biopmr/ModExo/README.md

ModExo (https://github.com/biopmr/ModExo)

## Contents
- [Landing Page](https://github.com/biopmr/ModExo)
- [Main Code](https://github.com/biopmr/ModExo/blob/master/arduino_control/arduino_control.ino)
- [Hardware](https://github.com/biopmr/ModExo/blob/master/hardware)
- [Experimental](https://github.com/biopmr/ModExo/blob/master/experimental)
- [Documents](https://github.com/biopmr/ModExo/blob/master/documents)
- Discussion

## Intro
Exoskeletons are often called wearable robots because of it's close interaction with the human. Being so, the exoskeletons must be responsive to user movement.

In this project, we desire to investigate the human joint and robotic joint interaction in a modular approach in a way that this is usefull for several applications.

## How to contribute
This project is on it's initial stages. If you want to contribute, take a look at the [Issues](https://github.com/biopmr/ModExo/issues) for already identified needs or at the [main code](https://github.com/biopmr/ModExo/blob/master/arduino_control/arduino_control.ino) and identify issues yourself!

## Testing
The hardware is not easy to set up by yourself. A workflow to test remote contributions is still needed. For now, just contact the e-mail below and we'll upload the changes and publish the results.

https://www.youtube.com/watch?v=oU2QiyaPxdo  
https://www.youtube.com/watch?v=PE7NVD3MYoc

## Contact
rafaelsanchezsouza@gmail.com

## License
[MIT](https://github.com/biopmr/modexo/blob/master/LICENSE)

Developed at Laboratório de Biomecatrônica at the Universidade de São Paulo.
