biopmr/ModExo/hardware/portableCase/README.md

  The ModExo Portable Case was built by Priscila Komatsu ([primiki](https://github.com/primiki)), a Lab's collaborator, and designed by Priscila Komatsu and Rafael Sanchez Souza ([rafaelsanchezsouza](https://github.com/rafaelsanchezsouza)). The result can be seen in figures that follows. 

## Requirements
The following requirements were defined for the case design:
- All the mechanical interface and control hardware must fit a portable case
- The robotic joint movement axis will rotate in parallel with the gravity
- The height of the case must be as low as possible 
- An emergency button should shut the whole system down if needed
- There should be communication between the control hardware inside the case and the equipment outside the case
- There should be space for control hardware volume, in the case that another degree of freedom is added 
- The control hardware must be visible with the case closed
- The interior of the case must be of easy access, in the need of maintenance
- There must be an exit for the power supply air expelled by the fan
- The motor must be supported by a rigid structure, that can support the weight of a person's arm

To follow these requirements, a case has been developed with a rectangular shape and the upper half is transparent and removable
with a slide motion. One side has a swivel joint to be easily accessible from the outside.

The material chosen to construct this case was a wood, because it is easy to manufacture and has a low cost, because the transparent part was chosen a
acrylic plate.

For the design developed, it used 3D CAD software, the Inventor by Autodesk.

## Pictures

ModExo Case

ModExo Case

ModExo Case

ModExo Case
