biopmr/ModExo/_images/_logo/readme.md

Gear by i cons from the Noun Project
Bone Joints by Vectors Market from the Noun Project
