biopmr/ModExo/documents/README.md

Here are gathered the most important documents used in the project, including datasheets, manuals, catalogues, amongst others. The following standard is applied for naming and finding documents:

	DocumentType-RelatedSubsystem-Content

For example, the manual which describes the cabling standards for the EPOS2 is:

	Manual-EPOS2-CableReferenceGuide.pdf

This standard is based on the document named Tutorial-Documentation-FileNamingConvention.pdf
