biopmr/ModExo/_images/_adaptive_control/a_3_3_3_ahat_3_01_3_tau_3.png

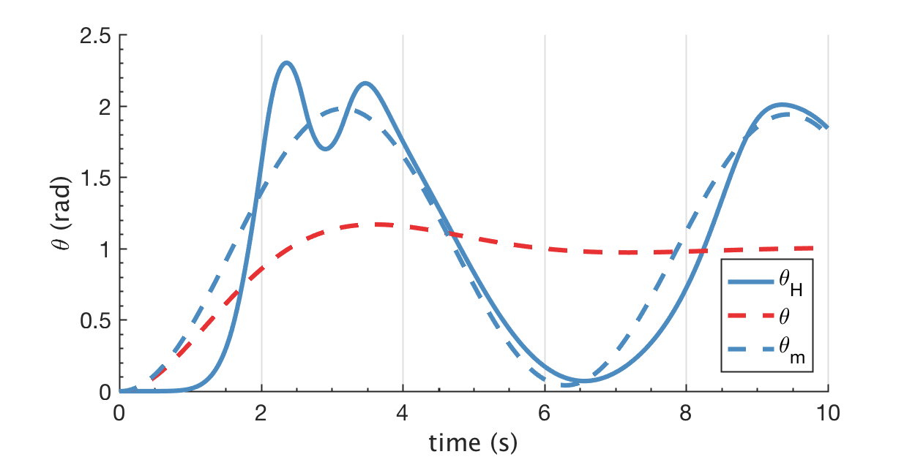
_images/_adaptive_control/a_3_3_3_ahat_3_01_3_tau_3.png
