biopmr/ModExo/_images/_adaptive_control/a_3_3_3_av_3_3_0_tau_3.png

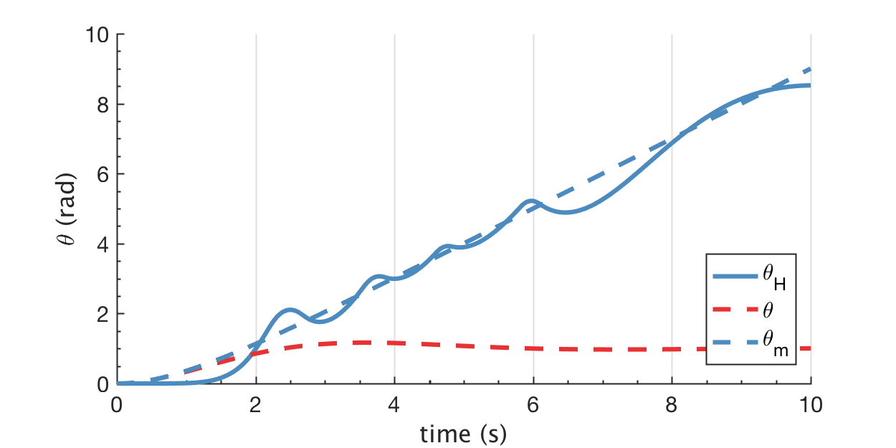
_images/_adaptive_control/a_3_3_3_av_3_3_0_tau_3.png
