biopmr/ModExo/_images/_adaptive_control/two_models_com_controle.png

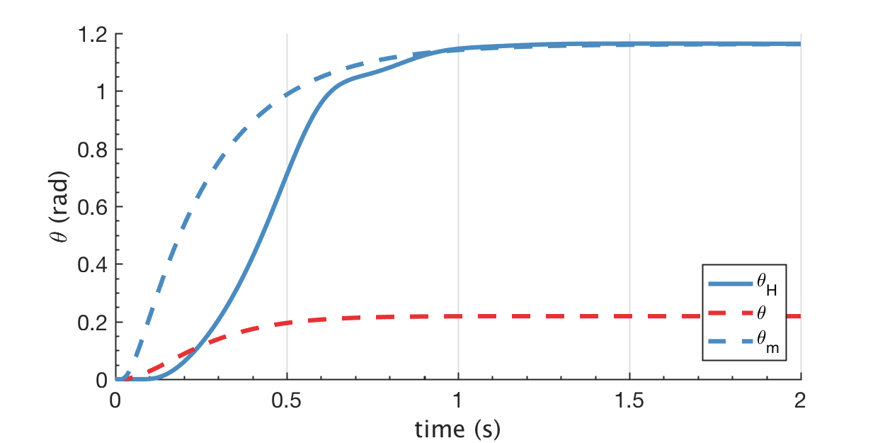
_images/_adaptive_control/two_models_com_controle.png
