biopmr/ModExo/telemetryviewer.png

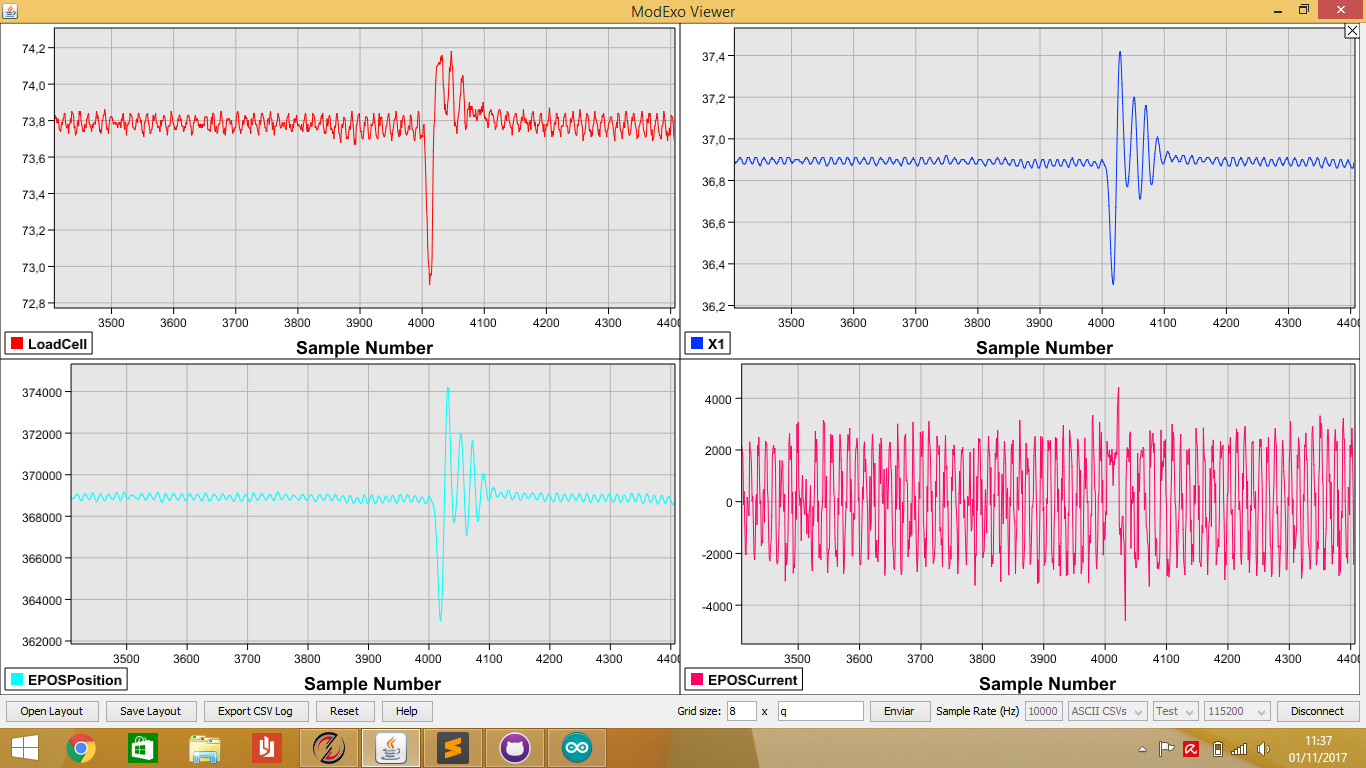
telemetryviewer.png
