biopmr/ModExo/hardware/wireCase/proteção celula de carga Rafa.stp

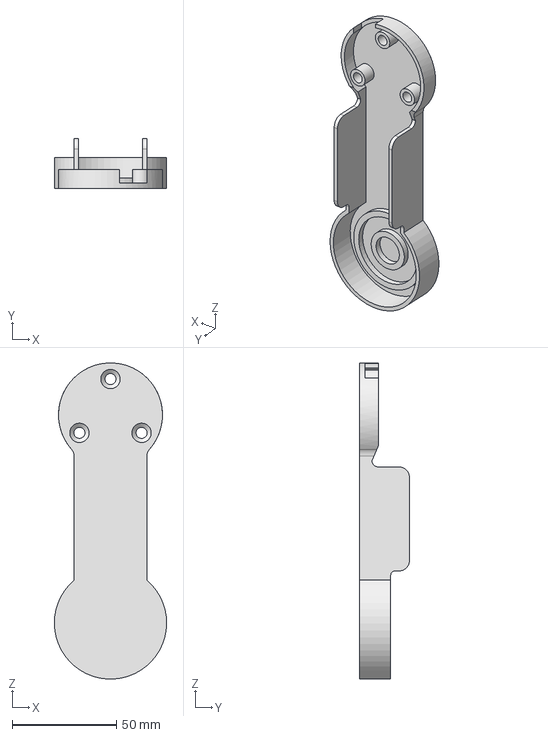
[picture p5: CAD file, 2017-11-28]
hardware/wireCase/proteção celula de carga Rafa.stp
54.0 x 24.0 x 151.9 mm
