biopmr/ModExo/(list of files, cad)

Other CAD files:
hardware/wireCase/proteção celula de carga Rafa.igs
hardware/wireCase/proteção celula de carga Rafa.ipt
