biopmr/ModExo/experimental/20170712-loadcell_tests-setup.png

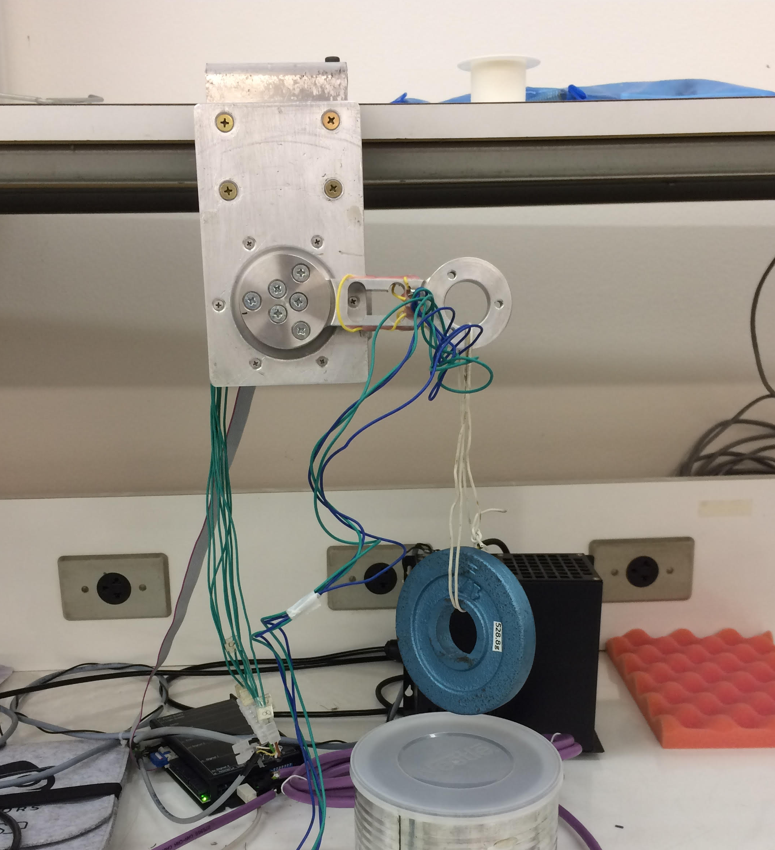
experimental/20170712-loadcell_tests-setup.png
