biopmr/ModExo/matlab/arduino_tests/decreasingStep.png

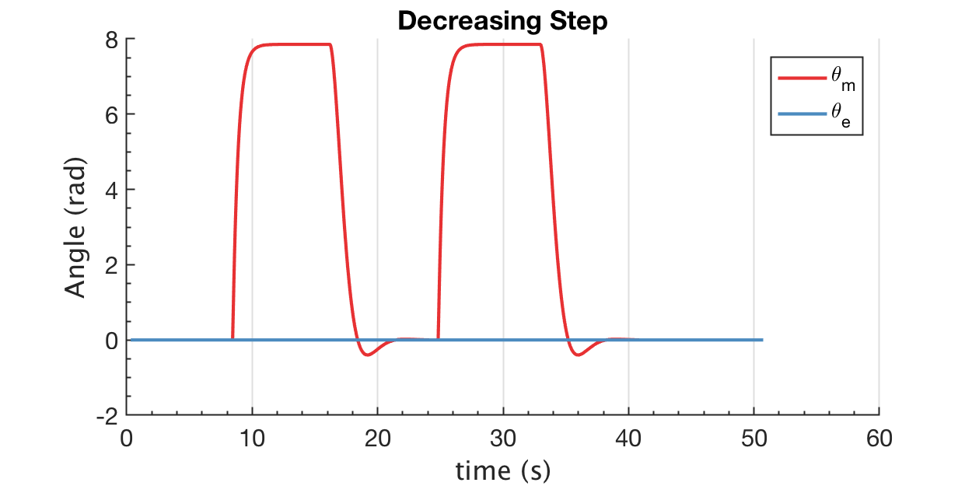
matlab/arduino_tests/decreasingStep.png
