biopmr/ModExo/experimental/csvData/20170705-interruptedFall-i_20_b_20_k_100.csv

Sample Number (10000 samples per second) | LoadCell () | X1 () | X2 () | X3 () | EPOSPosition () | EPOSCurrent ()
0 | 643.35 | 0.0 | 0.0 | 12866.92 | 4.0 | 19.0
1 | 643.39 | 0.0 | 64.33 | 6434.42 | 4.0 | 65526.0
2 | 642.85 | 0.32 | 96.51 | 1919.61 | 4.0 | 2.0
3 | 642.38 | 0.8 | 106.1 | -979.64 | 4.0 | 65526.0
4 | 643.27 | 1.33 | 101.21 | -2594.26 | 4.0 | 2.0
5 | 643.47 | 1.84 | 88.24 | -3317.25 | 4.0 | 65521.0
6 | 643.76 | 2.28 | 71.65 | -3417.56 | 4.0 | 41.0
7 | 642.95 | 2.64 | 54.56 | -3157.8 | 5.0 | 65101.0
8 | 642.79 | 2.91 | 38.77 | -2673.33 | 4.0 | 54.0
9 | 643.03 | 3.11 | 25.41 | -2107.46 | 4.0 | 65500.0
10 | 643.07 | 3.23 | 14.87 | -1561.04 | 4.0 | 65414.0
11 | 643.23 | 3.31 | 7.06 | -1074.52 | 4.0 | 6.0
12 | 643.44 | 3.34 | 1.69 | -674.35 | 4.0 | 65419.0
13 | 642.8 | 3.35 | -1.68 | -383.82 | 4.0 | 65375.0
14 | 642.66 | 3.34 | -3.6 | -161.17 | 4.0 | 65380.0
15 | 643.55 | 3.33 | -4.41 | 9.39 | 4.0 | 65393.0
16 | 642.81 | 3.3 | -4.36 | 77.9 | 4.0 | 65414.0
17 | 643.15 | 3.28 | -3.97 | 132.87 | 4.0 | 65410.0
18 | 642.98 | 3.26 | -3.31 | 142.46 | 4.0 | 65397.0
19 | 643.35 | 3.25 | -2.59 | 144.72 | 4.0 | 65375.0
20 | 643.06 | 3.23 | -1.87 | 118.45 | 4.0 | 65426.0
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
