biopmr/ModExo/experimental/csvData/20170707-delayTests_1.csv

Sample Number (10000 samples per second) | LoadCell () | X1 () | X2 () | X3 () | EPOSPosition () | EPOSCurrent () | Encoder () | Time (ms)
0 | 100.27 | 0.4 | -1.85 | 721.57 | 3870.0 | 31440.0 | 3802.0 | 332.0
1 | 100.98 | 0.4 | -1.78 | 715.4 | 3869.0 | 23450.0 | 0.0 | 382.0
2 | 94.66 | 0.39 | 1.79 | -728.32 | 3960.0 | 630040.0 | 0.0 | 433.0
3 | 100.27 | 0.4 | -1.85 | 721.57 | 3870.0 | 31440.0 | 0.0 | 484.0
4 | 95.25 | 0.0 | 0.0 | 2381.27 | 0.0 | 0.0 | 0.0 | 534.0
5 | 91.58 | 0.0 | 11.91 | -2175.26 | 65.0 | 14120.0 | 0.0 | 584.0
6 | 87.63 | 0.06 | 1.03 | 1432.41 | 4.2949673E9 | 647250.0 | 0.0 | 634.0
7 | 81.48 | 0.06 | 8.19 | -1439.37 | 108.0 | 32310.0 | 0.0 | 686.0
8 | 89.62 | 0.11 | 1.0 | 1207.0 | 573.0 | 627320.0 | 0.0 | 736.0
9 | 83.31 | 0.11 | 7.03 | -1244.86 | 933.0 | 636580.0 | 0.0 | 786.0
10 | 90.9 | 0.15 | 0.81 | 1059.28 | 1131.0 | 635340.0 | 0.0 | 836.0
11 | 86.93 | 0.15 | 6.1 | -1051.33 | 1224.0 | 46220.0 | 0.0 | 886.0
12 | 91.96 | 0.18 | 0.85 | 854.96 | 1523.0 | 628190.0 | 0.0 | 937.0
13 | 88.08 | 0.18 | 5.12 | -871.58 | 1653.0 | 27820.0 | 0.0 | 988.0
14 | 92.76 | 0.38 | 1.5 | -610.68 | 38.98 | 829.62 | 0.0 | 1038.0
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
