biopmr/ModExo/experimental/csvData/20170707-delayTests_2.csv

Sample Number (10000 samples per second) | LoadCell () | X1 () | X2 () | X3 () | EPOSPosition () | EPOSCurrent () | Encoder () | Time (ms)
1 | 41.41 | 0.0 | 0.0 | 1035.18 | 43699.0 | 0.0 | 0.0 | 320.0
2 | 53.45 | 0.0 | 5.18 | -604.76 | 42642.0 | 59743.0 | 0.0 | 349.0
3 | 59.3 | 0.03 | 2.15 | 513.82 | 40072.0 | 60990.0 | 0.0 | 399.0
4 | 67.02 | 0.04 | 4.72 | -323.91 | 37092.0 | 59309.0 | 0.0 | 449.0
5 | 72.68 | 0.06 | 3.1 | 277.27 | 33762.0 | 62342.0 | 0.0 | 500.0
6 | 80.4 | 0.08 | 4.49 | -146.41 | 30426.0 | 62419.0 | 0.0 | 550.0
7 | 89.1 | 0.1 | 3.76 | 205.26 | 27091.0 | 61892.0 | 0.0 | 601.0
8 | 86.41 | 0.12 | 4.78 | -364.16 | 23763.0 | 62466.0 | 0.0 | 651.0
9 | 92.32 | 0.14 | 2.96 | 317.0 | 20427.0 | 62316.0 | 0.0 | 702.0
10 | 97.16 | 0.16 | 4.55 | -248.99 | 17094.0 | 62233.0 | 0.0 | 752.0
11 | 102.35 | 0.18 | 3.3 | 205.54 | 13769.0 | 7.0 | 0.0 | 802.0
12 | 104.88 | 0.19 | 4.33 | -219.85 | 10780.0 | 65511.0 | 0.0 | 852.0
13 | 108.94 | 0.22 | 3.23 | 158.56 | 8216.0 | 65439.0 | 0.0 | 903.0
14 | 112.54 | 0.23 | 4.02 | -149.63 | 6077.0 | 283.0 | 0.0 | 954.0
15 | 113.6 | 0.25 | 3.27 | 31.69 | 4054.0 | 419.0 | 0.0 | 1004.0
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
