biopmr/ModExo/experimental/20170707-delay_test_1-response.png

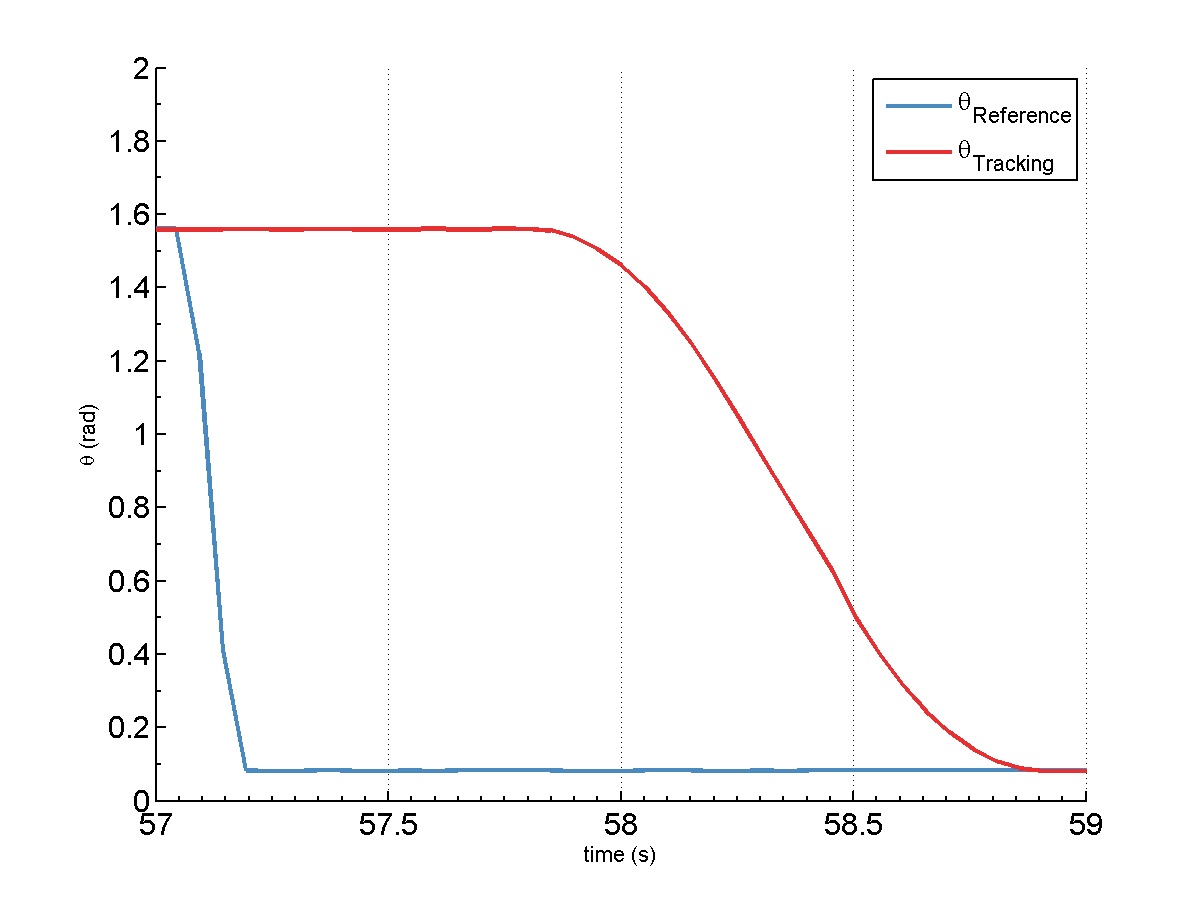
experimental/20170707-delay_test_1-response.png
