biopmr/ModExo/experimental/20170707-delay_test_2-response.png

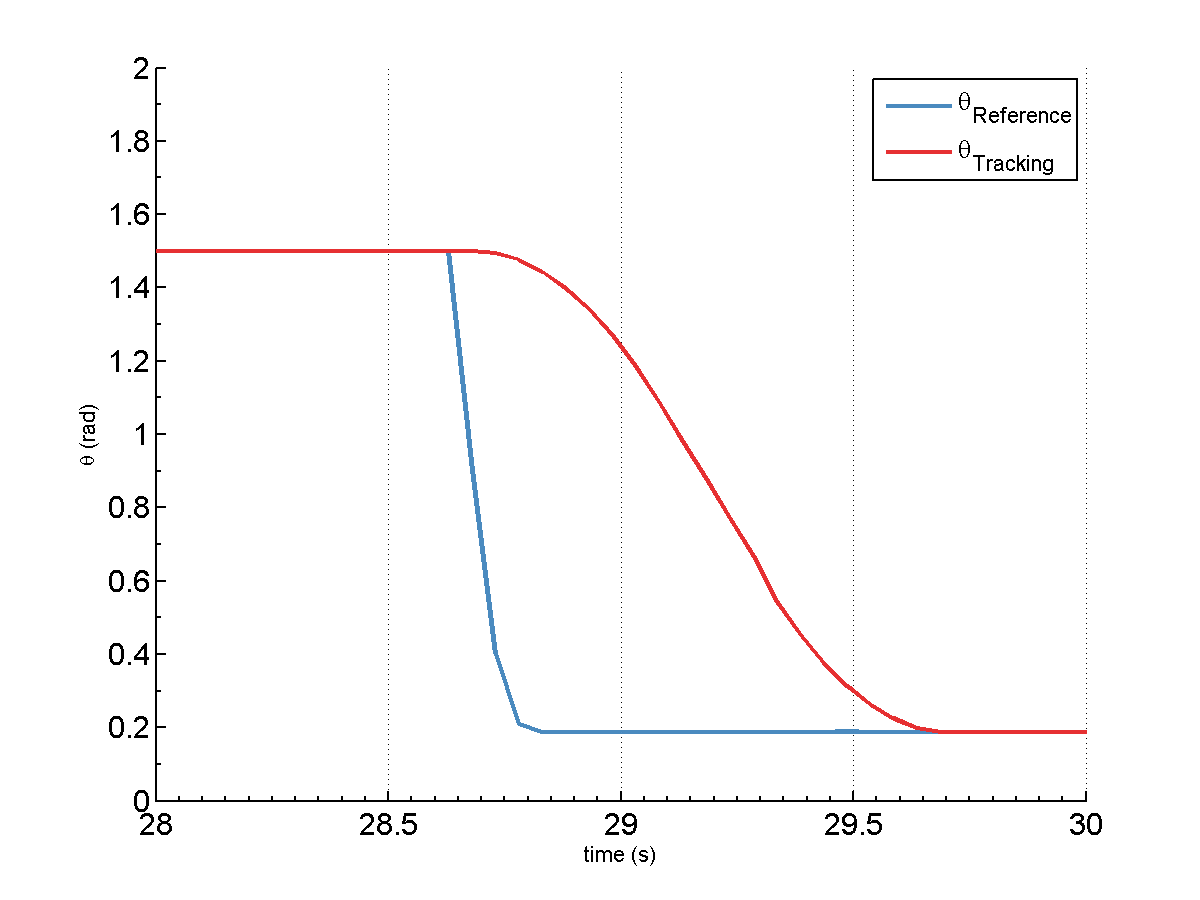
experimental/20170707-delay_test_2-response.png
