biopmr/ModExo/experimental/20170707-delay_test_3-response.png

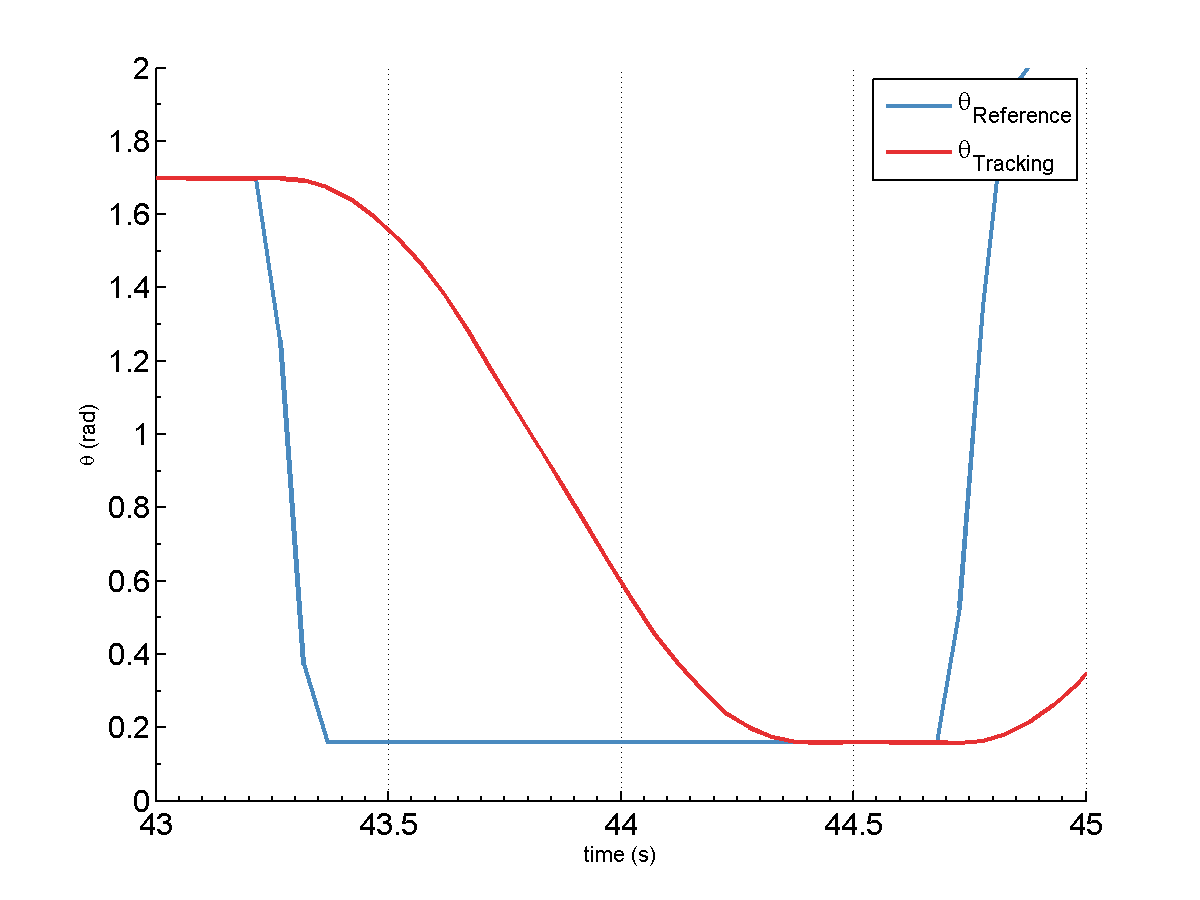
experimental/20170707-delay_test_3-response.png
