biopmr/ModExo/experimental/20170707-delay_tests_1-settings.png

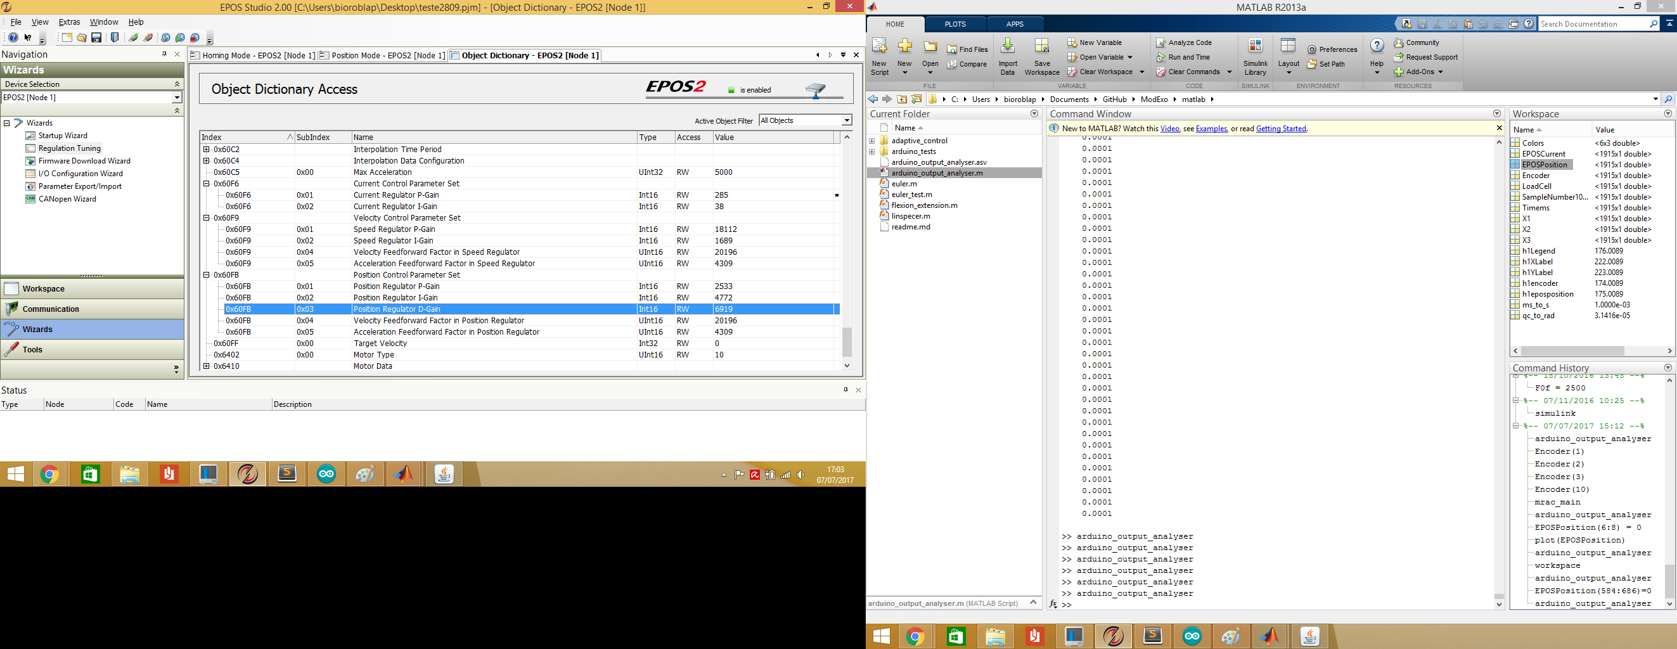
experimental/20170707-delay_tests_1-settings.png
