biopmr/ModExo/experimental/20170707-delay_tests_3-settings.png

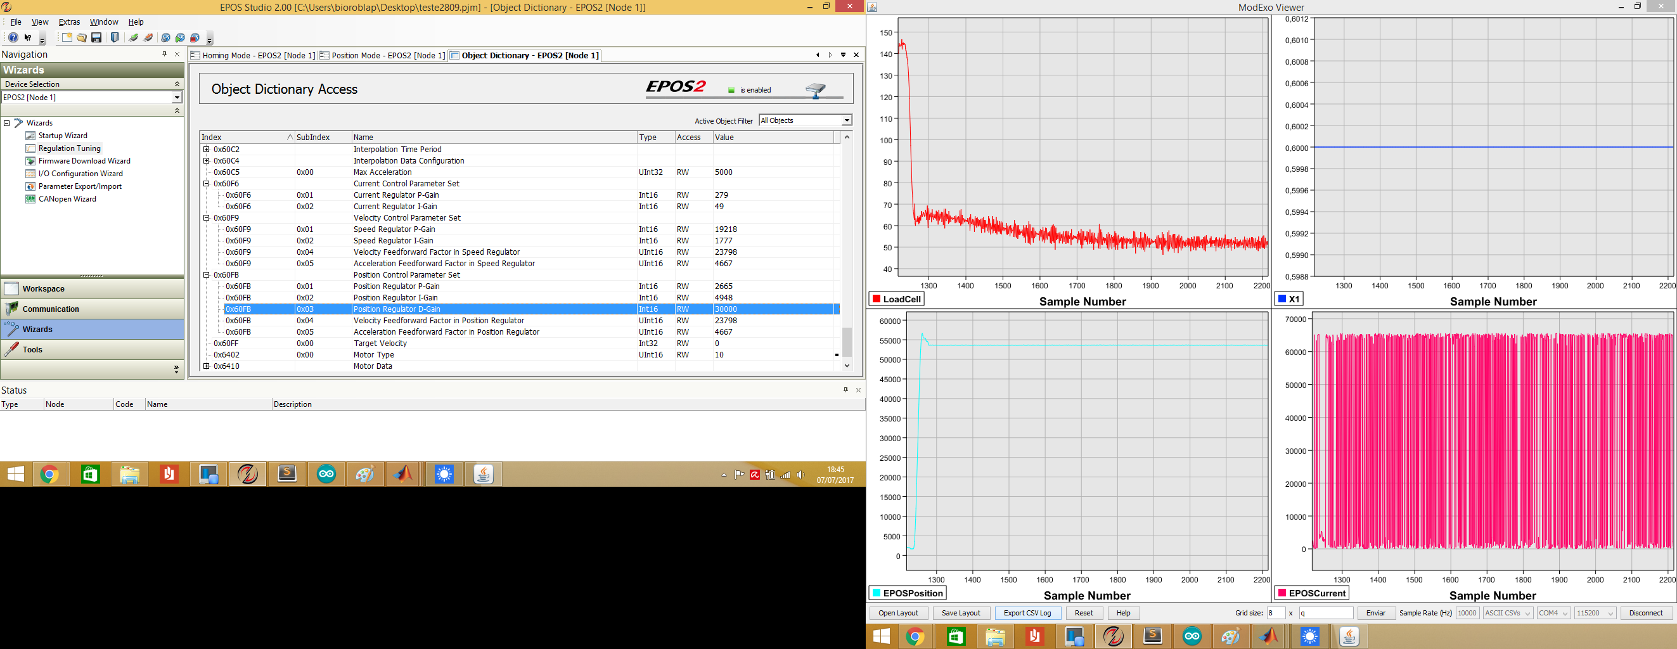
experimental/20170707-delay_tests_3-settings.png
