biopmr/ModExo/experimental/20170712-loadcell_tests.png

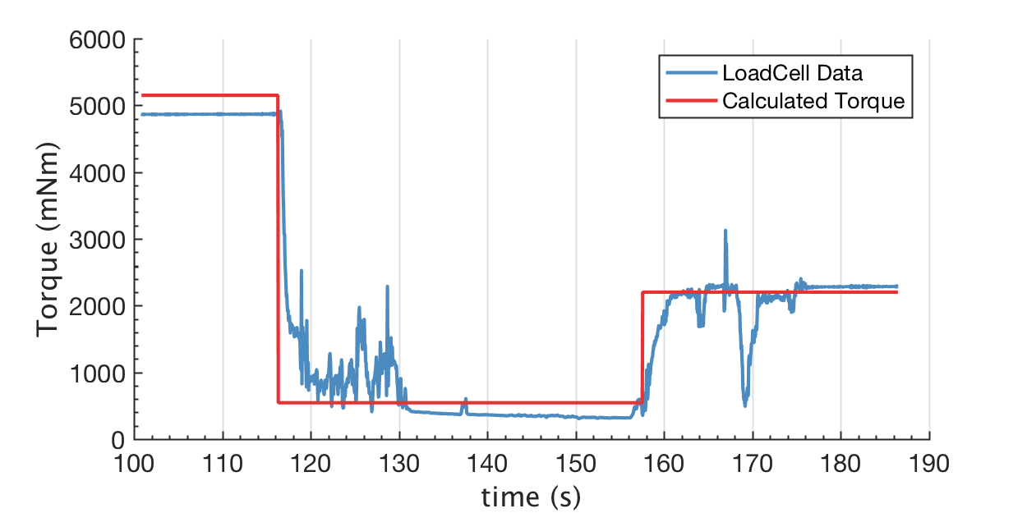
experimental/20170712-loadcell_tests.png
