biopmr/ModExo/experimental/20170712-loadcell_tests_2.png

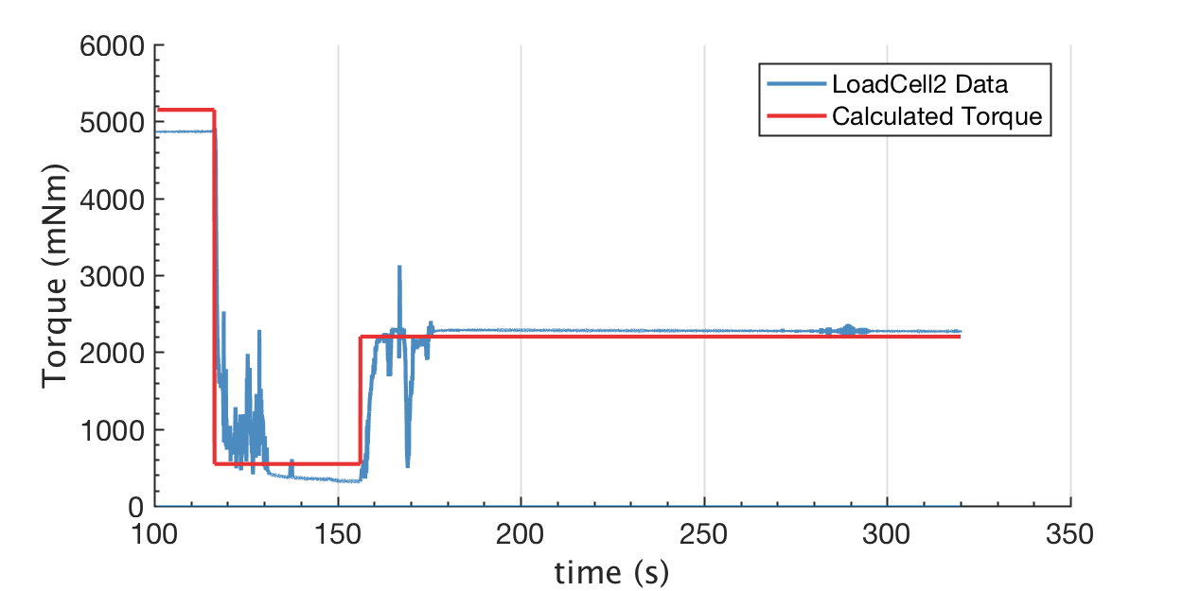
experimental/20170712-loadcell_tests_2.png
