biopmr/ModExo/matlab/adaptive_control/test_mrac.png

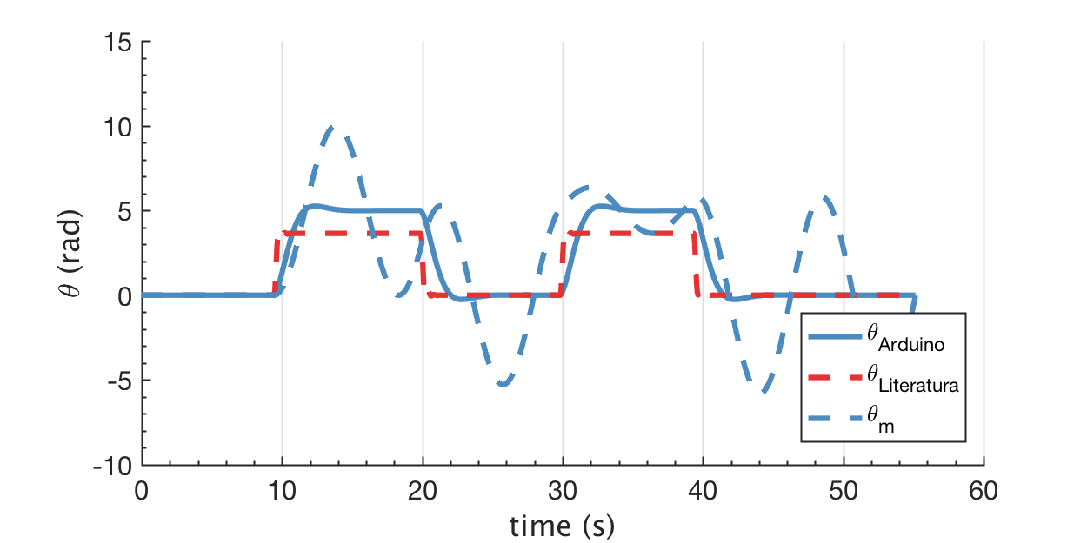
matlab/adaptive_control/test_mrac.png
