biopmr/ModExo/matlab/arduino_tests/delay_test_1_response.png

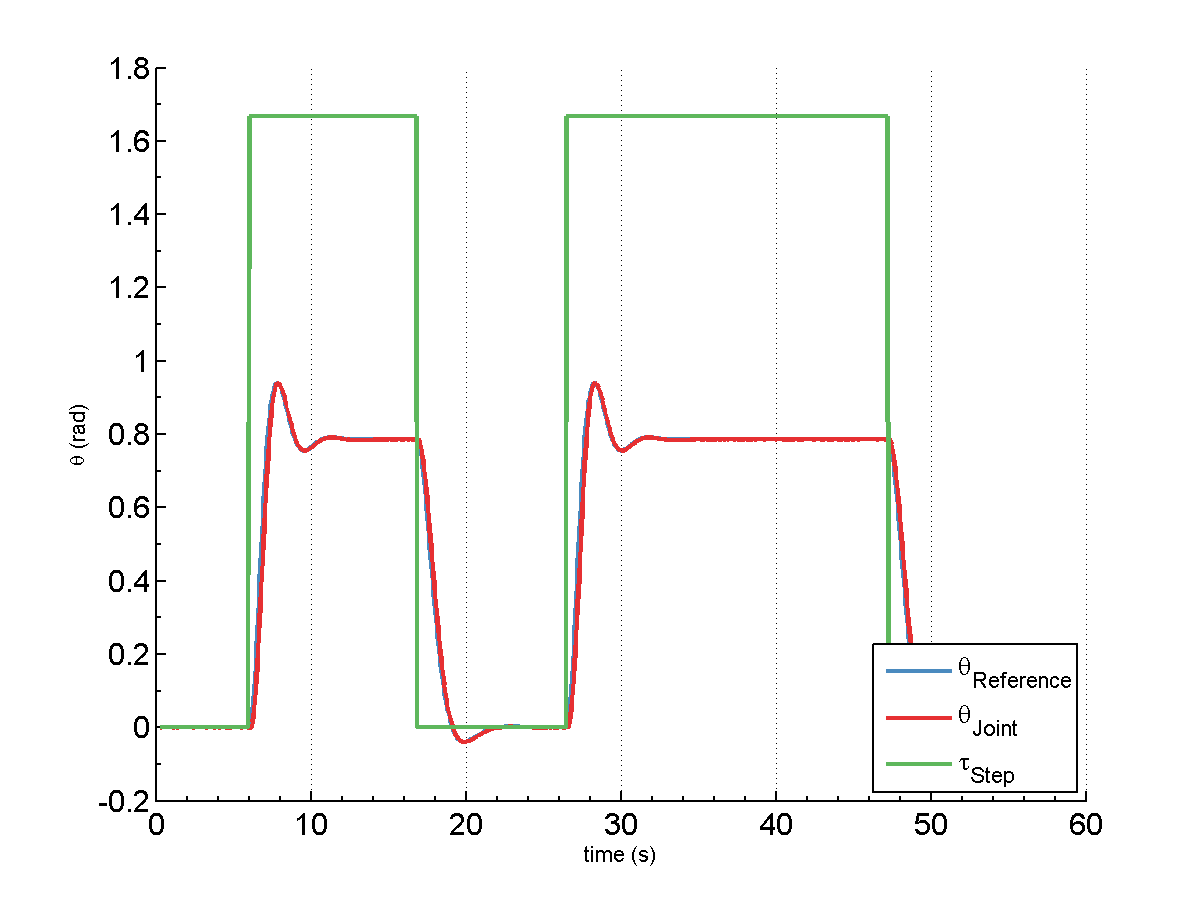
matlab/arduino_tests/delay_test_1_response.png
