biopmr/ModExo/matlab/arduino_tests/delay_test_2_response.png

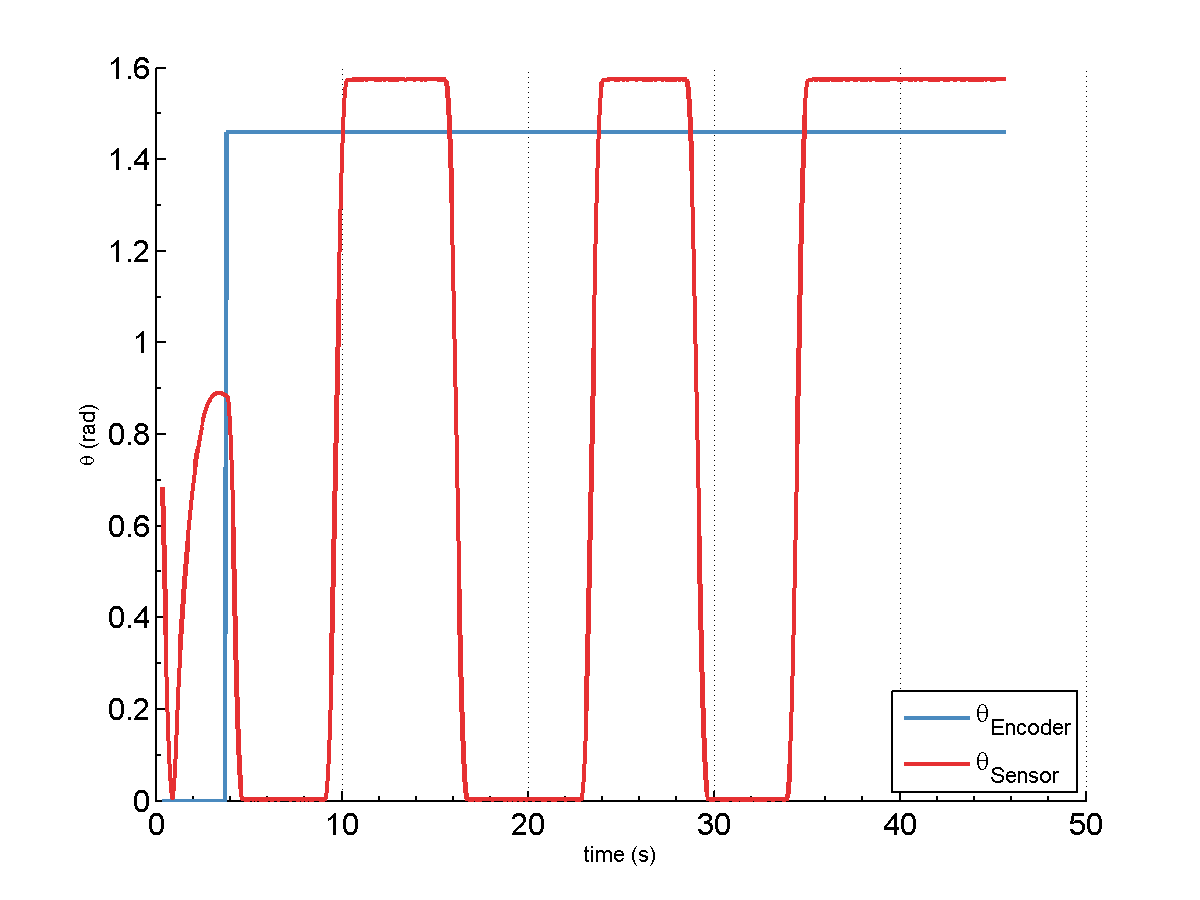
matlab/arduino_tests/delay_test_2_response.png
