biopmr/ModExo/matlab/arduino_tests/impedance_1_plot_1.png

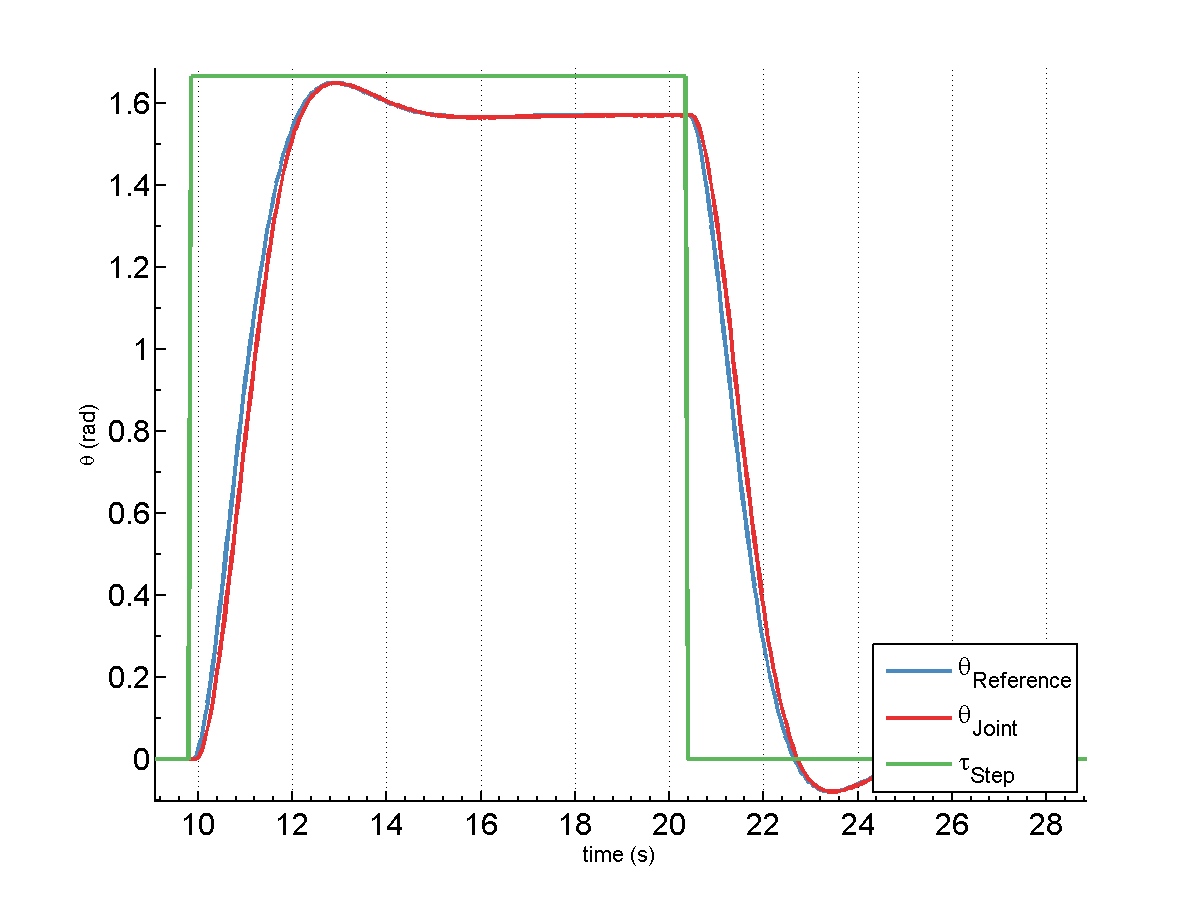
matlab/arduino_tests/impedance_1_plot_1.png
