biopmr/ModExo/matlab/arduino_tests/impedance_1_plot_2.png

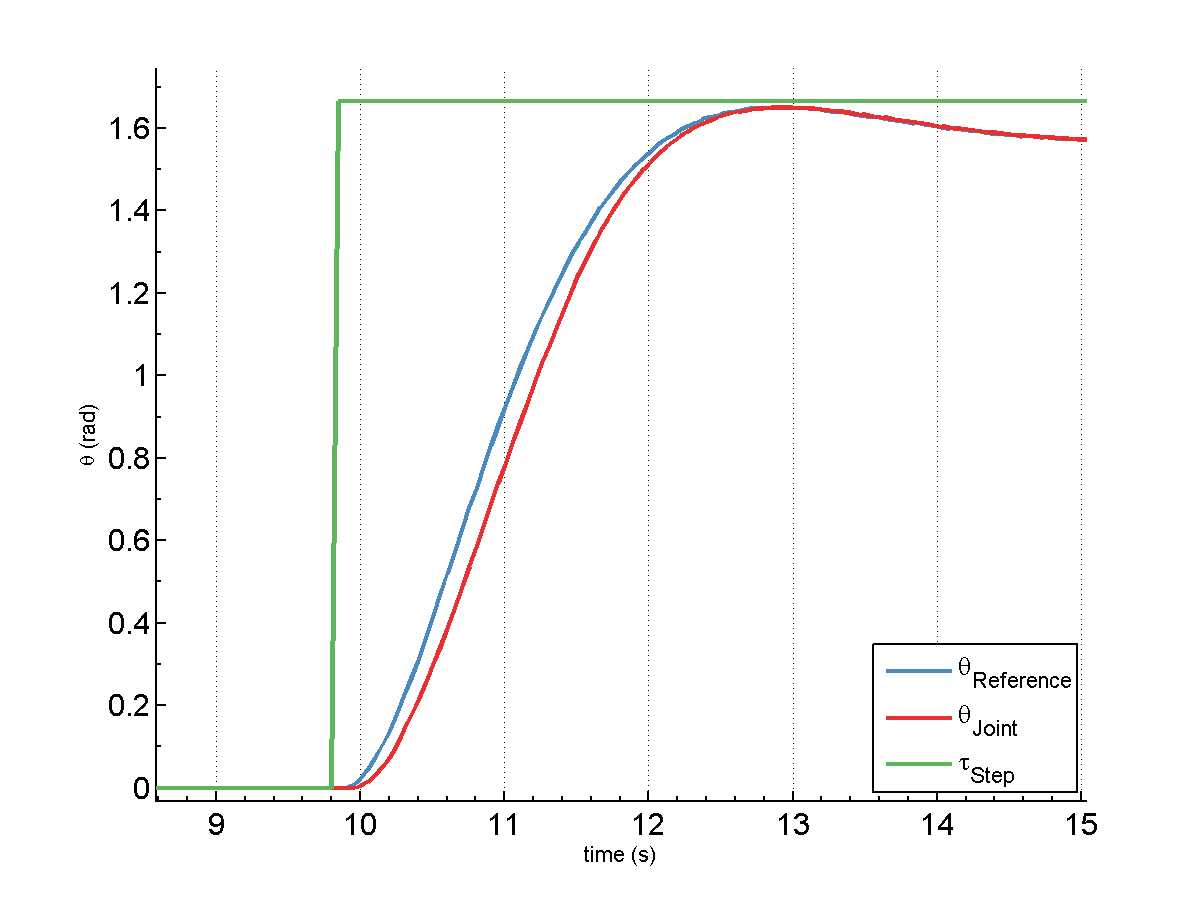
matlab/arduino_tests/impedance_1_plot_2.png
