biopmr/ModExo/matlab/arduino_tests/impedance_2_plot_1.png

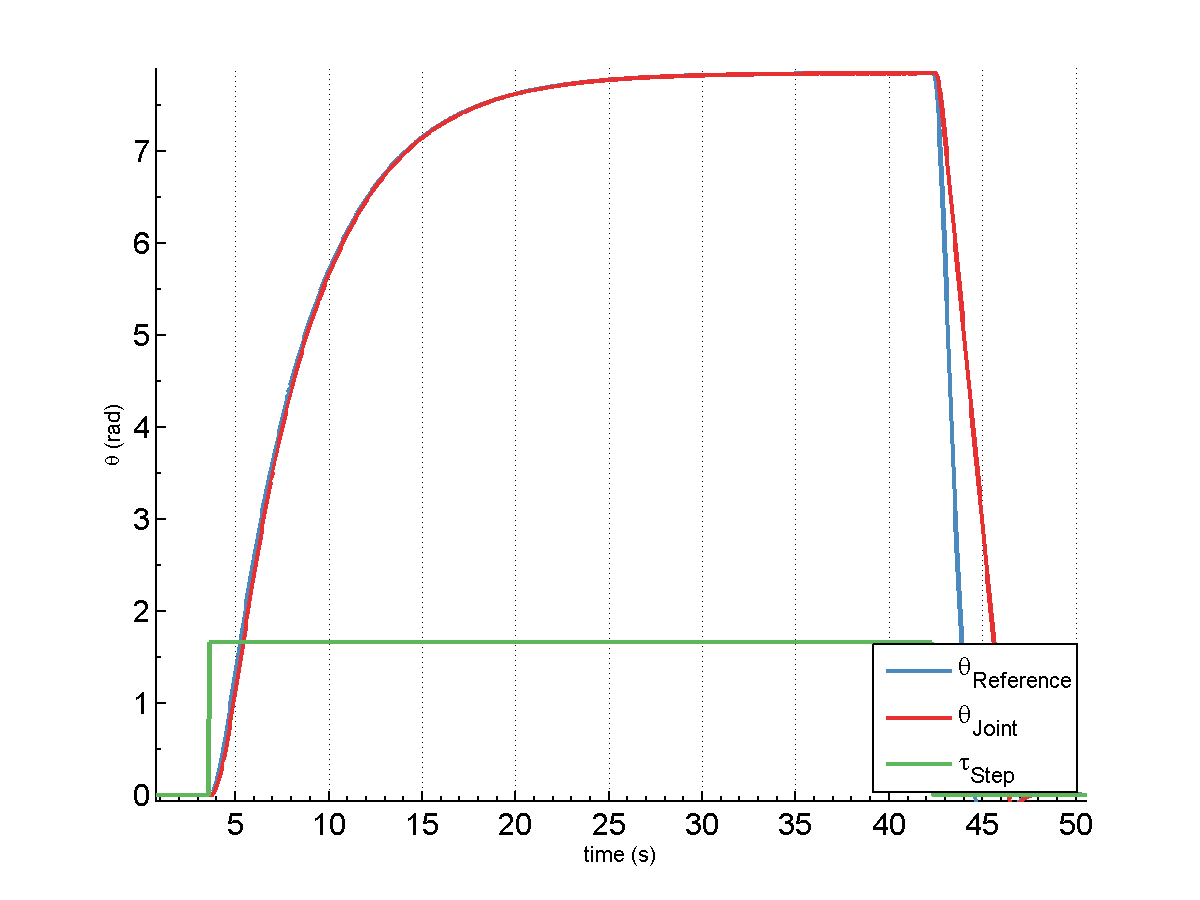
matlab/arduino_tests/impedance_2_plot_1.png
