biopmr/ModExo/matlab/arduino_tests/impedance_3_plot_1.png

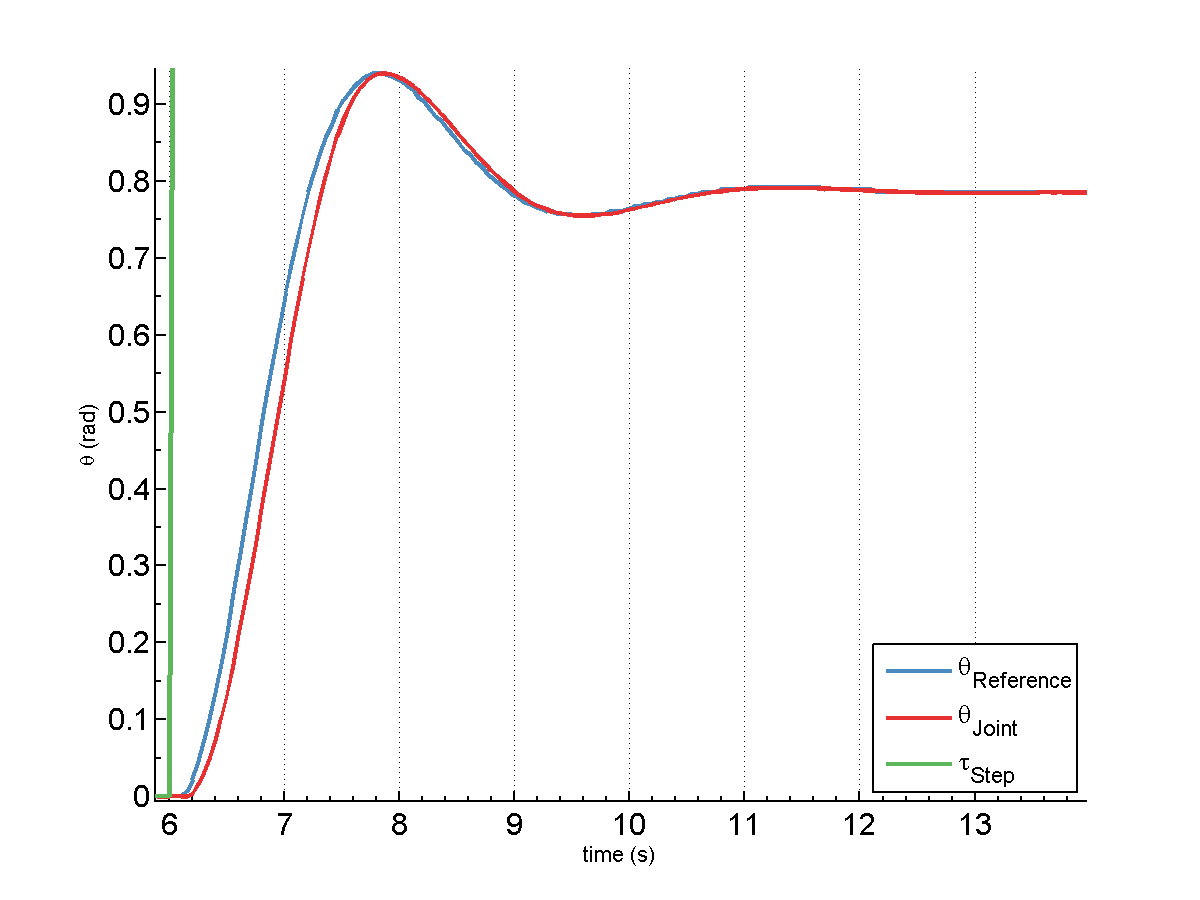
matlab/arduino_tests/impedance_3_plot_1.png
