biopmr/ModExo/matlab/arduino_tests/parameterEstimationRatios.png

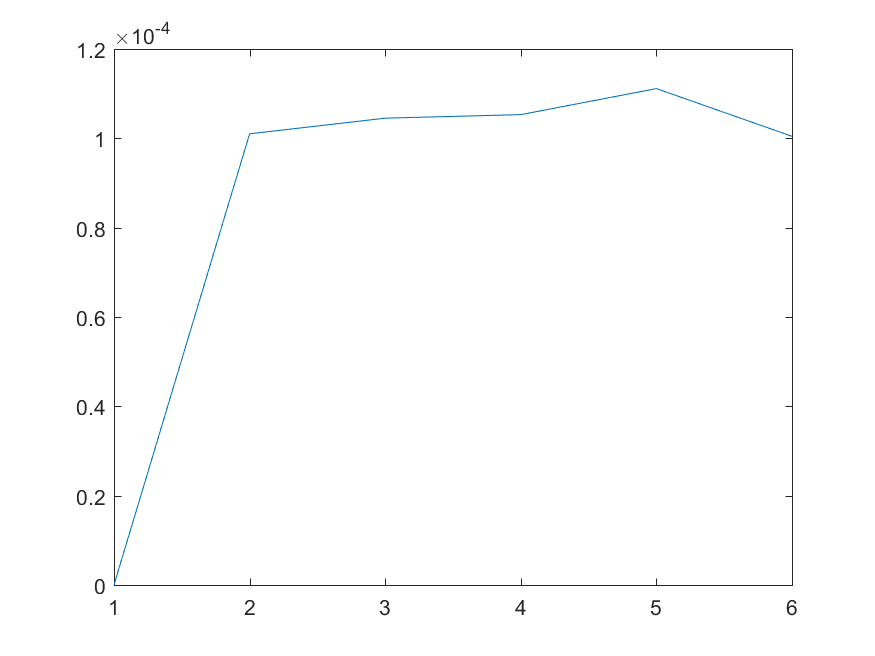
matlab/arduino_tests/parameterEstimationRatios.png
