biopmr/ModExo/(threads)

Thread 3 (2017-06-01):

the controller should be able to read data from all sensors

rafaelsanchezsouza, 2017-06-01:
### Expected behaviour
there is a list on incoming CAN messages coming from the nodes with three IDs
- 181: current
- 381: position
- 321: amplification board containing data from potentiometer and strain gauge
the controller should be able to read data from all sensors, identifying the respective sensor and ID

### Actual behaviour
the controller reads the data and manages to identify them, however, we need to understand if the strategy employed is efficient
it seems that the acquisition frequency of the sensors is different

### Steps to reproduce behaviour
1. CANDataRead() is the function responsible for this task
2. The controller should be able to read all the incoming data
3. The controller should be able to sort the incoming data

Closed 2017-06-02.

Thread 18 (2017-08-18):

Build Encoder Cable

afc1969, 2017-08-18:
Desired Behaviour
Robust cable which does not split when moving

Steps to reproduce behaviour
1. Understand the inputs and outputs
2. Choose conector standard (Molex strap-on or DIN)
3. Build cable
