biopmr/ModExo/hardware/controlHardwareCommunication.pdf

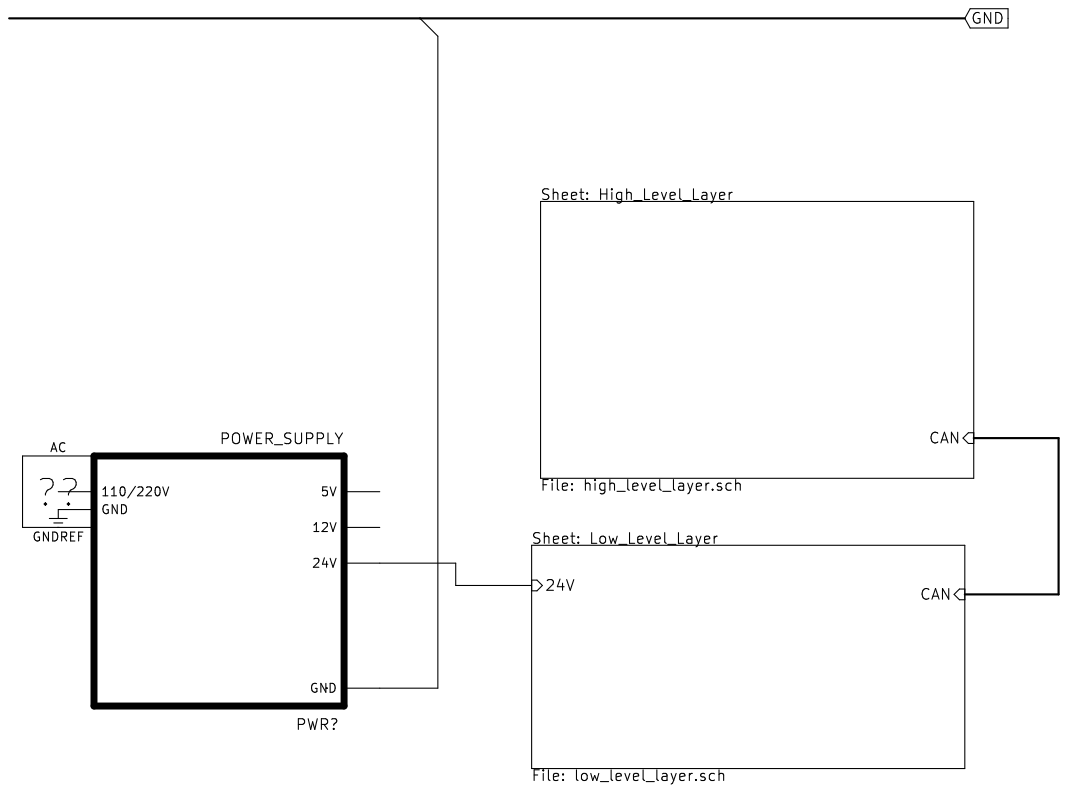
[picture p31: page 1]

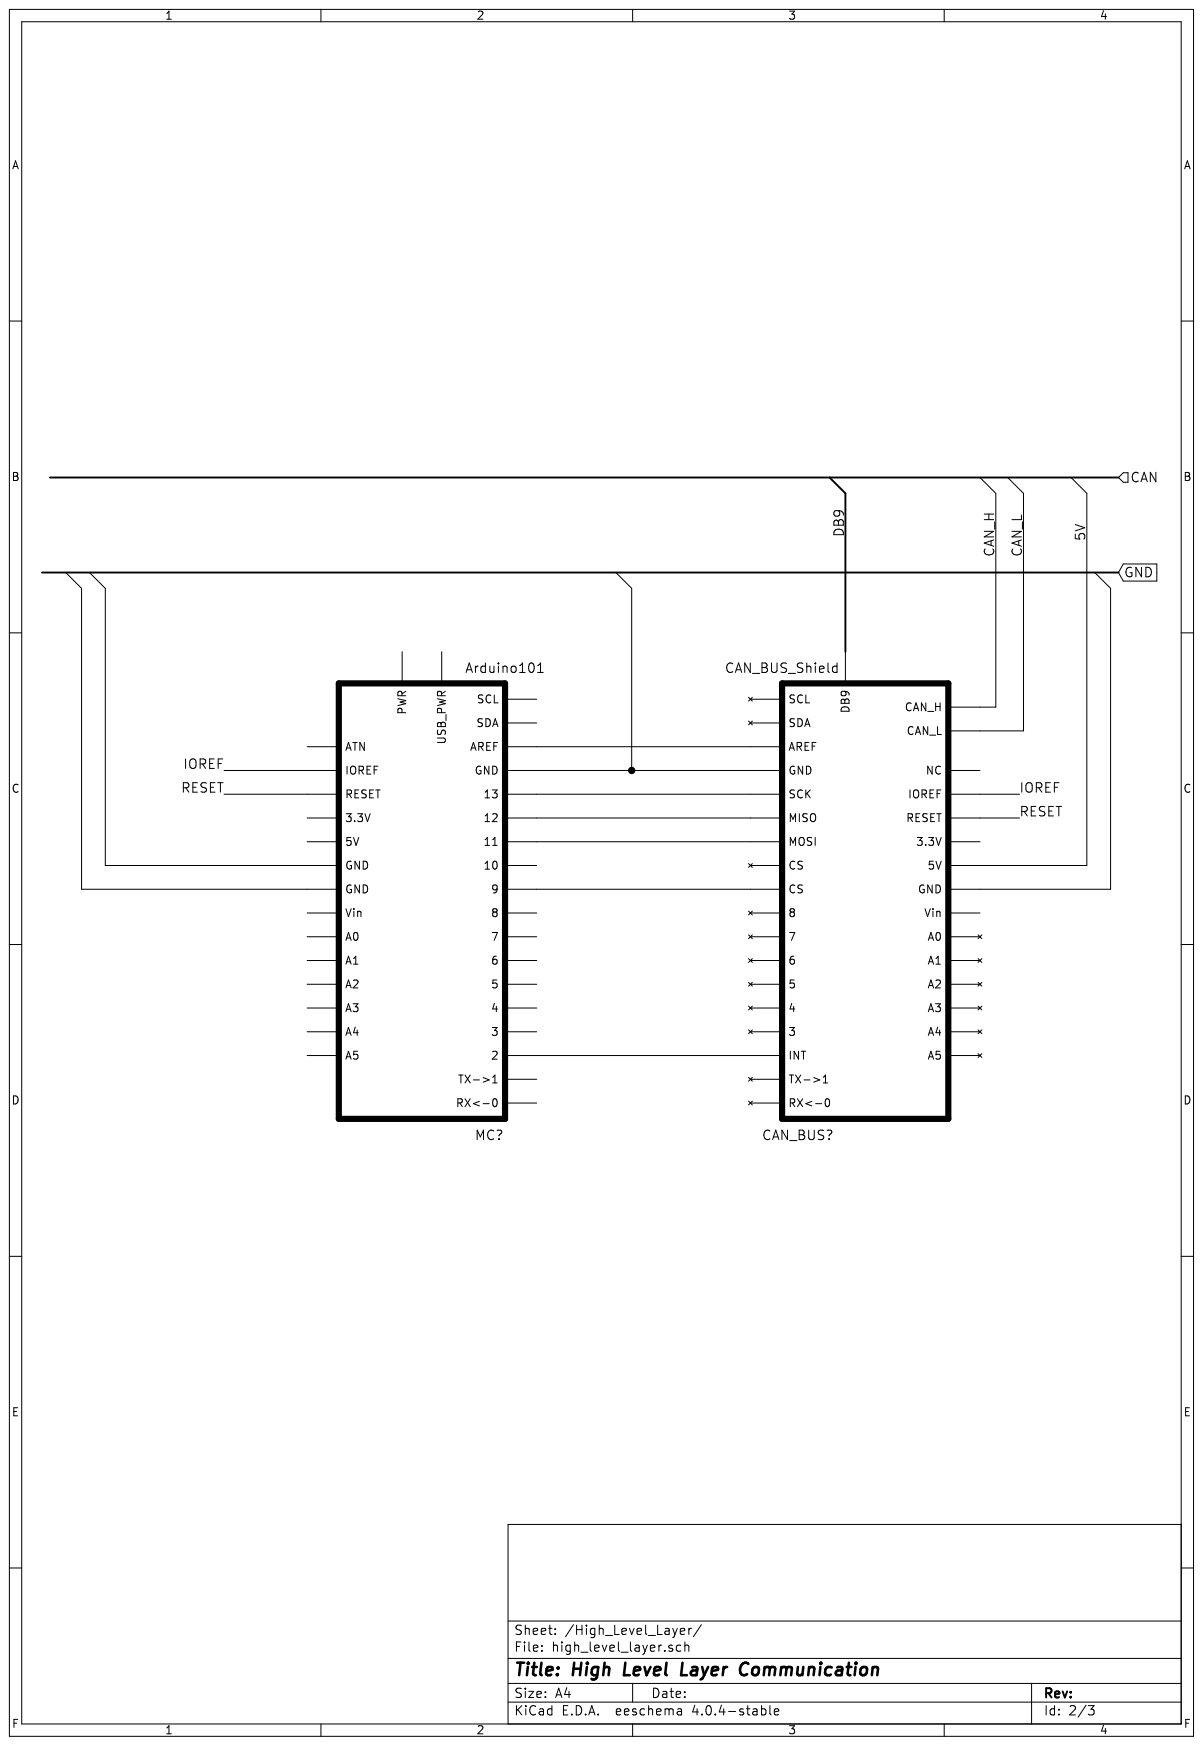
[picture p32: page 2]

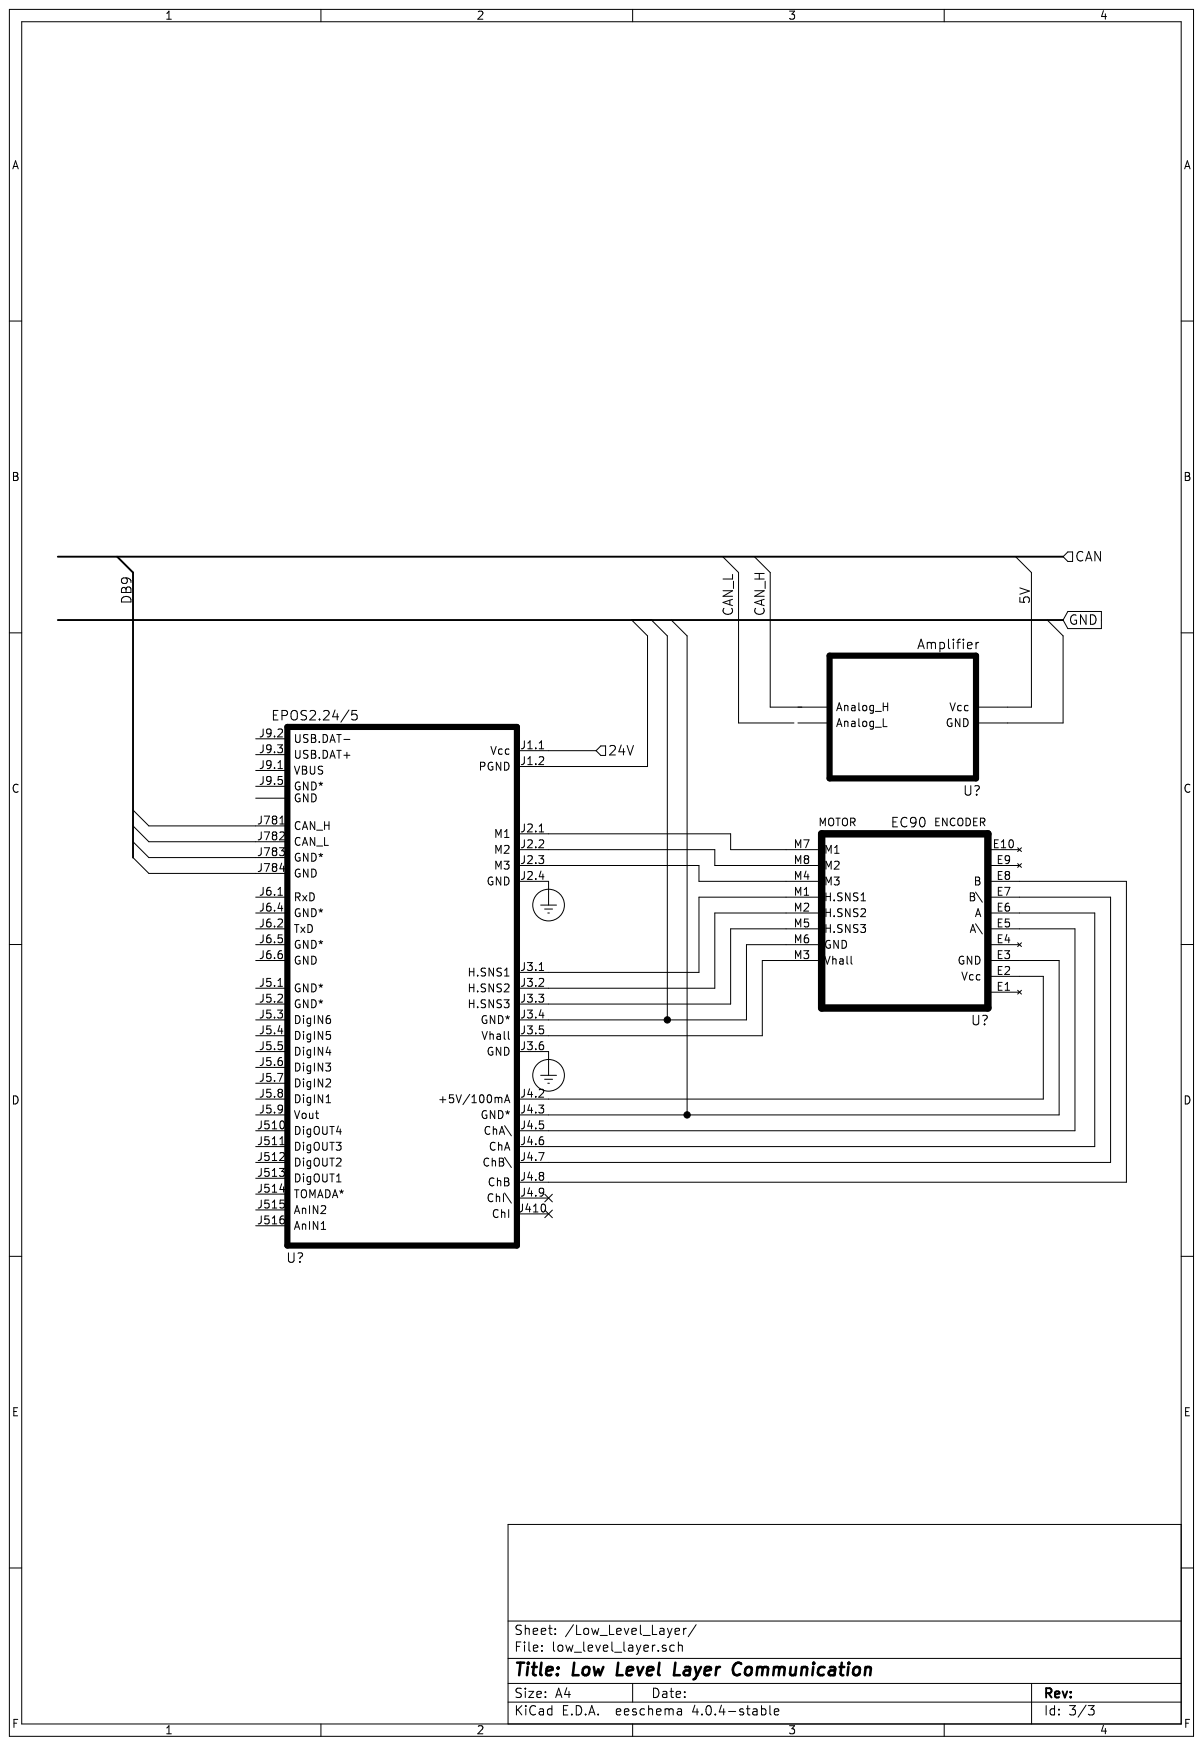
[picture p33: page 3]
