biopmr/ModExo/arduino_control/ModExo.h

//**************************************************************************
//------- Laboratorio de Biomecatronica @ Universidade de Sao Paulo --------
//
// Version: 1.0
// Date: 15.06.2017 [mm.dd.yyyy]
// Description
//  CAN Communication between Arduino and EPOS2 for Exoskeleton Control
// Input files:
// (None)
//
// Final Output files:
//   (None)
//
// References
//  http://wiki.seeed.cc/CAN-BUS_Shield_V1.2/
//  http://www.instructables.com/id/Arduino-Timer-Interrupts/
//  http://forum.arduino.cc/index.php?topic=225789.0
//  
//**************************************************************************
// Steps
//**************************************************************************

#include <SPI.h>
#include "mcp_can.h"
#include <mcp_can_dfs.h>

// Define States
#define Startup               1
#define PDOConfiguration       2
#define Operational           3
#define OperationalEncoderControl 4
#define SetPreOperational 5
#define OperationalDifferentialControl   6 
#define SetOperational 7
#define GoHome 8
#define Step 9

// Statemachine State variable and initial value
byte State = Startup;

// the cs pin of the version after v1.1 is default to D9
// v0.9b and v1.0 is default D10
const int SPI_CS_PIN = 9;
// Set CS pin
MCP_CAN CAN(SPI_CS_PIN); 

// Sensor variables
int32_t encoder_data = 0;
uint32_t current_data = 0;
int current_int = 0;
int32_t actualposition_data = 0;
int32_t loadcell_data = 0;
double loadcell_data_double = 0;
bool sync_flag = 0; 

// Sensor variables
double user_setpoint = 0;
double targetposition = 0;

// ***************************
// EPOS2 CANOpen Communication
// ***************************
//
// Data comes with Lowest Bit First

// Statemachine
unsigned char set_preoperational[2] = {0x80, 0};
unsigned char set_operational[2] = {0x1, 0};
unsigned char enable_epos[8] = {0x2B, 0x40, 0x60, 0, 0x0F, 0, 0, 0};
unsigned char disable_epos[8] = {0x2B, 0x40, 0x60, 0, 0x06, 0, 0, 0};

// PDO Configuration
unsigned char pdo_sync[1] = {0x00};

unsigned char pdo_actual_position_1[8] = {0x22, 0x02, 0x18, 0x01, 0x81, 0x03, 0, 0};
unsigned char pdo_actual_position_2[8] = {0x22, 0x02, 0x18, 0x02, 0x01, 0, 0, 0};

unsigned char pdo_actual_velocity_1[8] = {0x22, 0x02, 0x18, 0x01, 0x81, 0x03, 0, 0};
unsigned char pdo_actual_velocity_2[8] = {0x22, 0x02, 0x18, 0x02, 0x01, 0, 0, 0};

unsigned char pdo_actual_current_1[8] = {0x22, 0x00, 0x1A, 0x00, 0x00, 0, 0, 0};
unsigned char pdo_actual_current_2[8] = {0x22, 0x00, 0x1A, 0x01, 0x10, 0, 0x78, 0x60};
unsigned char pdo_actual_current_3[8] = {0x22, 0x00, 0x1A, 0x02, 0x10, 0, 0x27, 0x20};
unsigned char pdo_actual_current_4[8] = {0x22, 0x00, 0x18, 0x02, 0x01, 0, 0, 0};
unsigned char pdo_actual_current_5[8] = {0x22, 0x00, 0x1A, 0x00, 0x01, 0, 0, 0};

// *****************
// Object Writing
// *****************

// // Objects [Index(LSB), Index(MSB), Sub-Index]
// unsigned char modes_of_operation[8] = {0x60, 0x60, 0x00};
// unsigned char set_homing_method[8] = {0x98, 0x60, 0x00};
// unsigned char controlword[8] = {0x40, 0x60, 0x00};
// unsigned char position_setting_value[8] = {0x00, 0x62, 0x20, 0x00, 0x00, 0x00, 0x00, 0x00};

// Parameters
unsigned char set_max_following_error[8] = {0x22, 0x65, 0x60, 0, 0xD0, 7, 0, 0};
unsigned char set_max_acceleration[8] = {0x22, 0xC5, 0x60, 0, 0x88, 0x13, 0, 0};
unsigned char set_max_profile_velocity[8] = {0x22, 0x7F, 0x60, 0, 0xD0, 7, 0, 0};
unsigned char set_min_position_limit[8] = {0x22, 0x7D, 0x60, 0x01, 0x7F, 0x7B, 0xE1, 0xFF}; // -300000qc = 0xFFFB6C20  -2000000qc=0xFFE17B7F
unsigned char set_max_position_limit[8] = {0x22, 0x7D, 0x60, 0x02, 0x80, 0x84, 0x1E, 0}; // 300000qc = 0x0493E0  2000000qc=0x1E8480

// Commanding
unsigned char setpoint_position[8] = {0x22, 0x62, 0x20, 0x00, 0, 0, 0, 0};

// *****************
// Object Reading
// *****************

// Actual Values
unsigned char get_actual_position[8] = {0x40, 0x64, 0x60, 0, 0, 0, 0, 0};
unsigned char get_actual_velocity[8] = {0x40, 0x6C, 0x60, 0, 0, 0, 0, 0};
unsigned char get_actual_current[8] = {0x40, 0x78, 0x60, 0, 0, 0, 0, 0};

// *****************
// System Variables
// *****************

int encoder_resolution = 2000; //2000 counts per turn
int reduction = 100; // harmonic drive reduction

int32_t last_encoder_position = 0;
int turn_counter=0;
int32_t angle_correction=0;
int32_t position_difference=0;

int CT_K = 0; // generic constant to be tweaked during runtime


// ******************
// System Parameters
// ******************
double x_0;
double x_1;
double x_2;
double x_3;
unsigned long dt0 = 0;
unsigned long dt1 = 0;
unsigned long dt = 0;

// human parameters (plant) {from Olaya cap5}
// long j_h = 0.115; // Nms^2/rad
// long b_h = 2.52; // Nms/rad [2.5-4.7]
// long k_h = 8.6; // Nm/rad [5.3-13.1]
long j_h = 0; // Nms^2/rad
long b_h = 0; // Nms/rad [2.5-4.7]
long k_h = 0; // Nm/rad [5.3-13.1]

// Thus our values for the parameters for the exoskeleton mechanism were Ie = 0.199 kg-m, be = 1.32 N-m-s/rad, ke = 5.12 N-m/rad
long j_exo = 0.199; // Nms^2/rad
long b_exo = 1.32; // Nms/rad [2.5-4.7]
long k_exo = 5.12; // Nm/rad [5.3-13.1]

// coupled system (plant)
long j_eq = j_h + j_exo; // Nms^2/rad
long b_eq = b_h + b_exo; // Nms/rad 
long k_eq = k_h + k_exo; // Nm/rad

// LoadCell Calibration
// [[loadcell_data_double = A*(force) + B]]
float A = 0.00764; //slop steepness
// float B = 118712.7; //offset
// float B = 3000; //offset
float B = 118712.7-3000; //offset
float d = 0.105; ////distancia entre os centros dos aros da celula de carga=10,5cm
double contactForce;
double contactTorque;
double stepTorque = 0;

//********************
// EPOS COMMUNICATION
//********************
//-----------------------------------------------------------------
void doStartup(void) 
{
  CAN.sendMsgBuf(0x601, 0, 8, disable_epos);
  delay(10);
  CAN.sendMsgBuf(0x601, 0, 8, enable_epos);
  Serial.println("EPOS enabled");
  delay(10);
  CAN.sendMsgBuf(0x601, 0, 8, set_max_following_error);
  Serial.println("Max Following Error set as 2000qc");
  delay(10);
  CAN.sendMsgBuf(0x601, 0, 8, set_max_acceleration);
  Serial.println("Max Aceeleration set as 5000rpm/s");
  delay(10);
  CAN.sendMsgBuf(0x601, 0, 8, set_max_profile_velocity);
  Serial.println("Max Profile Velocity set as 2000rpm");  
  delay(10);
  CAN.sendMsgBuf(0x601, 0, 8, set_min_position_limit);
  Serial.println("Min Position Limit defined as -2000000qc");  
  delay(10);
  CAN.sendMsgBuf(0x601, 0, 8, set_max_position_limit);
  Serial.println("Min Position Limit defined as 2000000qc");  
  delay(10);  
  State = PDOConfiguration;
}
//-----------------------------------------------------------------
void PDOConfig(void) {

  CAN.sendMsgBuf(0x00, 0, 2, set_preoperational);
  delay(10);
  CAN.sendMsgBuf(0x601, 0, 8, pdo_actual_position_1);
  delay(10);
  CAN.sendMsgBuf(0x601, 0, 8, pdo_actual_position_2);
  delay(10);
  // CAN.sendMsgBuf(0x601, 0, 8, pdo_actual_velocity_1);
  // delay(10);
  // CAN.sendMsgBuf(0x601, 0, 8, pdo_actual_velocity_2);
  delay(10);
  CAN.sendMsgBuf(0x601, 0, 8, pdo_actual_current_1);
  delay(10);
  CAN.sendMsgBuf(0x601, 0, 8, pdo_actual_current_2);
  delay(10);
  CAN.sendMsgBuf(0x601, 0, 8, pdo_actual_current_3);
  delay(10);
  CAN.sendMsgBuf(0x601, 0, 8, pdo_actual_current_4);
  delay(10);
  CAN.sendMsgBuf(0x601, 0, 8, pdo_actual_current_5);
  delay(10);
  CAN.sendMsgBuf(0x00, 0, 2, set_operational);
  delay(100);

  Serial.println("TPDO Configured!");
  
  delay(10);
  State = Operational;
}
//-----------------------------------------------------------------
void doHoming(void) {
  // Set Operation Mode
  // CAN.sendMsgBuf(0x601, 0, 8, {modes_of_operation, 0x06, 0x00});
  delay(10);
  // Set Homing Method

  // Enable Device

  // Start Homing
}
//-----------------------------------------------------------------
void positionSetpoint(uint32_t angle) 
{
  setpoint_position[4] = angle & 0xFF; 
  setpoint_position[5] = (angle >> 8) & 0xFF;
  setpoint_position[6] = (angle >> 16) & 0xFF;
  setpoint_position[7] = (angle >> 24) & 0xFF;

  // clear the string:
  CAN.sendMsgBuf(0x601, 0, 8, setpoint_position);
}
//-----------------------------------------------------------------
void sync(void) {
  CAN.sendMsgBuf(0x80, 0, 1, pdo_sync);
}

//********************
// DATA AQUISITION
//********************
//-----------------------------------------------------------------
float amplificationBoardDataRead()
{
  unsigned char len = 0;
  unsigned char buf[8];

  if (CAN_MSGAVAIL == CAN.checkReceive())           // check if data coming
  {
    CAN.readMsgBuf(&len, buf);    // read data,  len: data length, buf: data buf

    unsigned int canId = CAN.getCanId();

    // encoder information is read from buf[4] and buf[5] and converted to decimal
    encoder_data = buf[4];
    encoder_data <<= 8;
    encoder_data = encoder_data | buf[5];

    // // load cell information is read from buf[1], buf[2] and buf[3] and converted to decimal
    loadcell_data = buf[1];
    loadcell_data <<= 8;
    loadcell_data = loadcell_data | buf[2];
    loadcell_data <<= 8;
    loadcell_data = loadcell_data | buf[3];
    //
    //    if (buf[1] >= 128) {
    //           loadcell_data = loadcell_data - 16777216;
    //    }

    loadcell_data_double = loadcell_data;
    //  loadcell_data_double = loadcell_data_double-4294000000;

    //    Serial.print("Encoder: ");
    //    Serial.println(encoder_data, DEC);

     // Serial.print("Loadcell: ");
     // Serial.println(loadcell_data_double);

    return(encoder_data);
  }
}

//***********************
// INTERRUPTION
//***********************
ISR(TIMER1_COMPA_vect) { 
  sync_flag = 1;
}

//***********************
// INTERFACE
//***********************
//-----------------------------------------------------------------
void DataPrint()
{  

  // Serial.print("dt: ");
  // Serial.println(dt);

  // Serial.print("Load: ");
  Serial.print(contactTorque);
  Serial.print(",");

  // Serial.print("Load: ");
  Serial.print(stepTorque);
  Serial.print(",");

  // Serial.print("X_1: ");
  Serial.print(x_1);
  Serial.print(",");

  // Serial.print("X_2: ");
  Serial.print(x_2);
  Serial.print(",");

  // Serial.print("X_3: ");
  // Serial.print(x_3);
  // Serial.print(",");

  // Serial.print("EPOS Actual Position: ");
  Serial.print(actualposition_data);
  Serial.print(",");

  // Serial.print("EPOS Current");
  Serial.print(current_int);
  Serial.print(",");

  // Serial.print("Encoder");
  Serial.print(encoder_data);
  Serial.print(",");

  // Serial.print("Timestamp");
  Serial.print(millis());
  // Serial.print(",");

  // // Serial.print("Raw Load Data");
  // Serial.print(loadcell_data_double + B);

  Serial.print("\r\n");
}
//-----------------------------------------------------------------
int readSerialInteger() // (not sure if this works, must test)
{
  while(1)
  {
    if(Serial.available())
    { 
      return (Serial.parseInt());
    }
  }
}
//-----------------------------------------------------------------
void serialController(char command)
{
  switch(command)
  {
    case '1': // Startup
      State = Startup;
      Serial.println("State: Startup");
    break;
    case 'p': // PDOConfiguration
      State = PDOConfiguration;
      Serial.println("State: PDOConfiguration");
    break;
    case 'o': // Operational
      State = OperationalDifferentialControl;
      Serial.println("State: KControl");
    break;
    case 'q': // Encoder Control
      State = OperationalEncoderControl;
      Serial.println("State: EncoderControl");
    break;
    case 'k': // Pre Operational (not working)
      State = SetPreOperational;
      Serial.println("State: Disabled");
    break;
    case 'l': // Operational 
      State = SetOperational;
      Serial.println("State: Enabled");
    break;
    case 'd': // Differential Control
      State = OperationalDifferentialControl;
      Serial.println("State: DifferentialControl");
    break;
    case 'c': // Constant CT_K (generic constant)
      CT_K = readSerialInteger();
      Serial.print("CT_K value: ");
      Serial.println(CT_K);
    break;
    case 'z': // Go to position 0
      State = GoHome;
      Serial.print("Position Zero");
    break;
    case 's': // Step
      State = Step;
      Serial.print("Position Zero");
    break;
  } 
}

//****************
// CONTROL MODES
//****************
//-----------------------------------------------------------------
double gotoPositionZero()
{
  stepTorque = 0;
  unsigned char len = 0;
  unsigned char buf[8]; 

  if(CAN_MSGAVAIL == CAN.checkReceive())            // check if data coming
  {
    CAN.readMsgBuf(&len, buf);    // read data,  len: data length, buf: data buf
    unsigned int canId = CAN.getCanId();

    switch (canId) 
    {        
      case 0x181:
        current_data = buf[1];
        current_data <<= 8;
        current_data = current_data | buf[0];
        current_int = current_data;

        // Serial.print("Current Data: ");
        // Serial.println(current_data);
        break;
      case 0x381: // reads Position Actual Value

        actualposition_data = buf[5];
        actualposition_data <<= 8;
        actualposition_data = actualposition_data | buf[4];
        actualposition_data <<= 8;
        actualposition_data = actualposition_data | buf[3];
        actualposition_data <<= 8;
        actualposition_data = actualposition_data | buf[2];

        // Serial.print("Actual Position: ");
        // Serial.println(actualposition_data);

        return(actualposition_data);

        break;

      // ID 321 message has information sent by the amplification board
      // Messages coming from the amp_board has most significative bits coming first
      case 0x321:
        // // load_cell information is read from buf[1], buf[2] and buf[3] and converted to decimal
        loadcell_data = buf[1];
        loadcell_data <<= 8;
        loadcell_data = loadcell_data | buf[2];
        loadcell_data <<= 8;
        loadcell_data = loadcell_data | buf[3];

        if(buf[1] >= 128)
          loadcell_data |= 0xFF000000;

        encoder_data *= 200000 / 4096; //conversion to quadrature counts

        loadcell_data_double = loadcell_data; 
        // loadcell_data_double = loadcell_data_double + 130000;

        // if(loadcell_data_double>-4000&&loadcell_data_double<4000)
        //   loadcell_data_double = 0;

        contactForce = (loadcell_data + B)*A;
        contactTorque = contactForce*d; // mNm
        contactTorque = 0; // mNm (Used for Torque Step)

        x_1 = x_1 + 0.005*x_2;
        x_2 = x_2 + 0.005*x_3;
        // x_3 = 1/j_eq*(-b_eq*x_2 - k_eq*x_1 + contactTorque);
        x_3 = 20*(-1*x_2 - 10*x_1 + contactTorque); // works
        // x_3 = 20*(contactTorque); // doesnt work
        // x_3 = 20*(-5*x_2 - 50*x_1 + contactTorque + 10*sin(x_1*(pi/(4*50000))); // anti gravity
        
        targetposition = 10000*x_1;
        positionSetpoint(targetposition);

        DataPrint();

        break;
      }
  }
}
//-----------------------------------------------------------------
float doStep()
{
  unsigned char len = 0;
  unsigned char buf[8]; 

  if(CAN_MSGAVAIL == CAN.checkReceive())            // check if data coming
  {
    CAN.readMsgBuf(&len, buf);    // read data,  len: data length, buf: data buf
    unsigned int canId = CAN.getCanId();

    switch (canId) 
    {        
      case 0x181:
        current_data = buf[1];
        current_data <<= 8;
        current_data = current_data | buf[0];
        current_int = current_data;

        // Serial.print("Current Data: ");
        // Serial.println(current_data);
        break;
      case 0x381: // reads Position Actual Value

        actualposition_data = buf[5];
        actualposition_data <<= 8;
        actualposition_data = actualposition_data | buf[4];
        actualposition_data <<= 8;
        actualposition_data = actualposition_data | buf[3];
        actualposition_data <<= 8;
        actualposition_data = actualposition_data | buf[2];

        // Serial.print("Actual Position: ");
        // Serial.println(actualposition_data);

        return(actualposition_data);

        break;

      // ID 321 message has information sent by the amplification board
      // Messages coming from the amp_board has most significative bits coming first
      case 0x321:
        // encoderDataRead();
        encoder_data = buf[4];
        encoder_data <<= 8; // bitshift equals times 2^8
        encoder_data = encoder_data | buf[5]; // sum operation

        // // load_cell information is read from buf[1], buf[2] and buf[3] and converted to decimal
        loadcell_data = buf[1];
        loadcell_data <<= 8;
        loadcell_data = loadcell_data | buf[2];
        loadcell_data <<= 8;
        loadcell_data = loadcell_data | buf[3];

        if(buf[1] >= 128)
          loadcell_data |= 0xFF000000;

        loadcell_data_double = loadcell_data +B;

        encoder_data *= 200000 / 4096; //conversion to quadrature counts

        positionSetpoint(50100);

        contactForce = (loadcell_data + B)*A;
        contactTorque = contactForce*d; // mNm

        DataPrint();

        break;
      }
  }
}
//-----------------------------------------------------------------
int32_t HexToDec(int32_t data_array[4])
{
  int32_t decimal_value=0;
  for (int i=1; i<=sizeof(data_array); i++){
    decimal_value <<= 8;
    decimal_value= decimal_value | data_array[i];
  }
  return(decimal_value);

}

//-----------------------------------------------------------------

float EncoderControl()
{
  unsigned char len = 0;
  unsigned char buf[8]; 

  if(CAN_MSGAVAIL == CAN.checkReceive())            // check if data coming
  {
    CAN.readMsgBuf(&len, buf);    // read data,  len: data length, buf: data buf
    unsigned int canId = CAN.getCanId();

    switch (canId) 
    {        
      case 0x181:
        current_data = buf[1];
        current_data <<= 8;
        current_data = current_data | buf[0];
        current_int = current_data;

        // Serial.print("Current Data: ");
        // Serial.println(current_data);
        break;
      case 0x381: // reads Position Actual Value

        actualposition_data = buf[5];
        actualposition_data <<= 8;
        actualposition_data = actualposition_data | buf[4];
        actualposition_data <<= 8;
        actualposition_data = actualposition_data | buf[3];
        actualposition_data <<= 8;
        actualposition_data = actualposition_data | buf[2];
        //actualposition_data=HexToDec(buf[5],buf[4],buf[3],buf[2]); //testing

        // Serial.print("Actual Position: ");
        // Serial.println(actualposition_data);

        return(actualposition_data);

        break;

      // ID 321 message has information sent by the amplification board
      // Messages coming from the amp_board has most significative bits coming first
      case 0x321:
        // encoderDataRead();
        encoder_data = buf[4];
        encoder_data <<= 8; // bitshift equals times 2^8
        encoder_data = encoder_data | buf[5]; // sum operation


        // // load_cell information is read from buf[1], buf[2] and buf[3] and converted to decimal
        loadcell_data = buf[1];
        loadcell_data <<= 8;
        loadcell_data = loadcell_data | buf[2];
        loadcell_data <<= 8;
        loadcell_data = loadcell_data | buf[3];

        if(buf[1] >= 128)
          loadcell_data |= 0xFF000000;

        loadcell_data_double = loadcell_data +B;

        encoder_data *= 200000 / 4096; //conversion to quadrature counts
 
        position_difference=encoder_data-last_encoder_position;

        if (encoder_data<600000 && encoder_data>-600000){   //check if 
          if(position_difference>120000){   // 120000=arbitrary value to verify difference
            turn_counter-=1;                //update turn_counter          
          }
          else if(position_difference<-120000){
            turn_counter+=1;
          }
        }
        
        angle_correction=encoder_data+196608*turn_counter; //
        
        last_encoder_position=encoder_data;  //update last_encoder_position
        positionSetpoint(angle_correction); 

        contactForce = (loadcell_data + B)*A;
        contactTorque = contactForce*d; // mNm

        DataPrint();

        break;
      }
  }
}
//-----------------------------------------------------------------

double differentialControl()
{

  x_0 = (encoder_data+196608*turn_counter)/10000; // home position
  x_1 = x_1 + 0.05*x_2;
  x_2 = x_2 + 0.05*x_3;
  // x_3 = 1/j_eq*(-b_eq*x_2 - k_eq*x_1 + contactTorque);
  // x_3 = 10*(-0.4*x_2 - 2*x_1 + contactTorque/10); // works
  x_3 = 10*(-0.4*x_2 - 2*(x_1-x_0) + contactTorque/10); // works
  // x_3 = 20*(-5*x_2 - 50*x_1 + contactTorque + 10*sin(x_1*(pi/(4*50000))); // anti gravity
  
  //targetposition = 10000*x_1+angle_correction;// teste modo differential+Encoder Home Control
  targetposition = 10000*x_1;
  positionSetpoint(targetposition);

  unsigned char len = 0;
  unsigned char buf[8]; 

  if(CAN_MSGAVAIL == CAN.checkReceive())            // check if data coming
  {
    CAN.readMsgBuf(&len, buf);    // read data,  len: data length, buf: data buf
    unsigned int canId = CAN.getCanId();

    switch (canId) 
    {        
      case 0x181:
        current_data = buf[1];
        current_data <<= 8;
        current_data = current_data | buf[0];
        current_int = current_data;

        // Serial.print("Current Data: ");
        // Serial.println(current_data);
        break;
      case 0x381: // reads Position Actual Value

        actualposition_data = buf[5];
        actualposition_data <<= 8;
        actualposition_data = actualposition_data | buf[4];
        actualposition_data <<= 8;
        actualposition_data = actualposition_data | buf[3];
        actualposition_data <<= 8;
        actualposition_data = actualposition_data | buf[2];

        if(buf[5] >= 128)
          actualposition_data |= 0xFF000000;

        // Serial.print("Actual Position: ");
        // Serial.println(actualposition_data);

        return(actualposition_data);

        break;

      // ID 321 message has information sent by the amplification board
      // Messages coming from the amp_board has most significative bits coming first
      case 0x321:
        // // load_cell information is read from buf[1], buf[2] and buf[3] and converted to decimal
        loadcell_data = buf[1];
        loadcell_data <<= 8;
        loadcell_data = loadcell_data | buf[2];
        loadcell_data <<= 8;
        loadcell_data = loadcell_data | buf[3];

        if(buf[1] >= 128)
          loadcell_data |= 0xFF000000;

        // encoderDataRead();
        encoder_data = buf[4];
        encoder_data <<= 8; // bitshift equals times 2^8
        encoder_data = encoder_data | buf[5]; // sum operation

        encoder_data *= 200000 / 4096; //conversion to quadrature counts
        position_difference=encoder_data-last_encoder_position;

        if (encoder_data<600000 && encoder_data>-600000){   //check if 
          if(position_difference>120000){   // 120000=arbitrary value to verify difference
            turn_counter-=1;                //update turn_counter          
          }
          else if(position_difference<-120000){
            turn_counter+=1;
          }
        }
        
        //angle_correction=encoder_data+196608*turn_counter; 
        last_encoder_position=encoder_data;  //update last_encoder_position

        loadcell_data_double = loadcell_data; 

        // if(loadcell_data_double>-4000&&loadcell_data_double<4000)
        //   loadcell_data_double = 0;

        contactForce = (loadcell_data + B)*A;
        contactTorque = contactForce*d; // mNm
        // stepTorque = 6; // mNm (Used for Torque Step)

        DataPrint();

        break;
      }
  }
}

//****************
// ARDUINO
//****************
//-----------------------------------------------------------------
void setupModExo() 
{
  Serial.begin(115200);

  while (CAN_OK != CAN.begin(CAN_1000KBPS))              // init can bus : baudrate = 500k
  {
    Serial.println("CAN BUS Shield init fail");
    Serial.println(" Init CAN BUS Shield again");
    delay(100);
  }

  Serial.println("CAN BUS Shield init ok!");

 // TIMER SETUP- the timer interrupt allows precise timed measurements of the reed switch
 //for mor info about configuration of arduino timers see http://arduino.cc/playground/Code/Timer1

 cli();//stop interrupts

 //set timer1 interrupt at 1kHz
 TCCR1A = 0;// set entire TCCR1A register to 0
 TCCR1B = 0;// same for TCCR1B\
 TCNT1  = 0;//initialize counter value to 0
 // set timer count for 1khz increments

 // OCR1A 1999 to 1kHZ, 19999 to 0.1kHz
 OCR1A = 19999;// = (16*10^6) / (1000*8) - 1
 //had to use 16 bit timer1 for this bc 1999>255, but could switch to timers 0 or 2 with larger prescaler
 // turn on CTC mode
 TCCR1B |= (1 << WGM12);
 // Set CS11 bit for 8 prescaler
 TCCR1B |= (1 << CS11);
 // enable timer compare interrupt
 TIMSK1 |= (1 << OCIE1A);

 sei();//allow interrupts
 //END TIMER SETUP
  
  Serial.println("Interrupt init ok!");
}
//-----------------------------------------------------------------
void loopModExo()
{
  switch (State) 
  {
    case Startup:
      doStartup();
      break;
    case PDOConfiguration:
      PDOConfig();
    case Operational:
      Serial.println("State: Operational");
      State = GoHome;
      // State = OperationalDifferentialControl;
      // State = OperationalEncoderControl;
    // EncoderControl();
      break;
    case GoHome:
      gotoPositionZero();
      break;
    case OperationalEncoderControl:
      EncoderControl();
      break;
    case SetPreOperational:
      CAN.sendMsgBuf(0x00, 0, 2, set_preoperational);
      delay(10);
      break; 
    case SetOperational:
      CAN.sendMsgBuf(0x00, 0, 2, set_operational);
      delay(10);
      break;  
    case Step:
      doStep();
      break;  
    case OperationalDifferentialControl:
      differentialControl();
      break;
  }

  if (sync_flag)
  {
    sync_flag=0;
    sync();
  }
  
  if(Serial.available())
  { 
    serialController(Serial.read());
  }
}

/*********************************************************************************************************
  END FILE
*********************************************************************************************************/
