biopmr/ModExo/(commit log)

2017-05-12 Initial commit
    current control code
    status: working as good as possible
2017-05-12 timer setup added
2017-05-13 interruption set to 0.1kHz
    loop() is not accessed with 1kHz
2017-05-15 test1
    issue encoder reading
    [send.ino]
2017-05-15 encoder reading done
    encoder information is read from buf[4] and buf[5] and converted to
    decimal
2017-05-15 load cell reading issue starts
    [send.ino]
2017-05-15 variables definition and code cleaning
    issue: preparing for merge encoder reading function
    [send.ino]
2017-05-15 minor fixes
    EPOS nos enabling
    [send.ino]
2017-05-15 tests made
    code is working
    robotic joint needs mapping
2017-05-15 system variables added
    status: system is working
    issue: MA3 encoder needs mapping to EPOS2
    [send.ino]
2017-05-15 issue angle mapping solved
    position setpoint function created
    status: strain gauge needs reading
    [send.ino]
2017-05-15 merged to arduino_control
2017-05-26 issue torque sensor reading
    torque sensor is exploding
    [send.ino]
2017-05-26 issue current read
    currentDataRead added
    [send.ino]
2017-05-26 issue current read
    minor changes
    [send.ino]
2017-05-26 merge send and arduino control
    work with arduino control from now on
    added SYNC function
2017-05-29 interrupt setting
2017-05-29 timer 1 configuration for 1kHz
2017-05-29 interruption configured ok
2017-05-29 issue data reading
    needs further debugging
    are all variables being read?
    [arduino_control.ino]
2017-06-01 attempt with states and if
    didn’t work
    [arduino_control.ino]
2017-06-02 resolves issue #3
    interruption function was overloading the arduino
    implements flag_sync
    [arduino_control.ino]
2017-06-05 control tests
    position setpoint from encoder not working
    [arduino_control.ino]
2017-06-05 issue #7 testing input array
    [arduino_control.ino]
2017-06-05 issue #7 testing
    not working yet, problems with types of variables and pointers
    [arduino_control.ino]
2017-06-08 tests with current data
2017-06-09 working on issue #10
    parameter Min Position Limit and Max Position Limit configured by CAN
    needs further improvement
    [arduino_control.ino]
2017-06-12 corrects unsigned variable issue
    [ModExo.h]
2017-06-12 first kcontrol prototype
    very unstable
    [ModExo.h]
2017-06-19 pot control changed to encoder control
2017-06-23 matlab adaptive control code
    [theta_EQ.csv, theta_EQ2.csv, theta_m.csv]
2017-06-30 attempt to implement homing
2017-07-05 testing dynamics
    testing dynamics
    - aquisition time for amplification board is 50ms
2017-07-06 manually revert last commit
    manually revert last commit
    [ModExo.h]
2017-07-07 print millis()
    Tests made to infer delay between setpoint and position
    [20170707_delay_tests_1.csv, 20170707_delay_tests_2.csv, 20170707_delay_tests_3.csv]
2017-07-11 update
    - arduino uno
    - control system overview
2017-07-12 laodcell tests
    [20170712_loadcell_tests_1.csv, 20170712_loadcell_tests_2.csv]
2017-07-14 folder change
    [20170707_delay_tests_1.csv, 20170707_delay_tests_2.csv, 20170707_delay_tests_3.csv, 20170712_loadcell_tests_1.csv, 20170712_loadcell_tests_2.csv]
2017-07-19 motor specifications
2017-08-04 can bus analyzer added
2017-08-04 name change according to standard
    [20170707-delay_tests_1.csv, 20170707-delay_tests_2.csv, 20170707-delay_tests_3.csv, 20170712-loadcell_tests_1.csv, 20170712-loadcell_tests_2.csv]
2017-08-07 removed first line (error in Timems)
    [20170707-delay_tests_2.csv]
2017-08-07 ma3 encoder datasheet added
2017-08-07 dynamic tests added
    [queda_interrompida_i_20_b_20_k_100.csv, queda_interrompida_i_20_b_5_k_200.csv, queda_livre.csv, queda_livre_i_20_b_20_k_100.csv]
2017-08-09 .csv data folder changed
    [20170707-delay_tests_1.csv, 20170707-delay_tests_2.csv, 20170707-delay_tests_3.csv, 20170712-loadcell_tests_1.csv, 20170712-loadcell_tests_2.csv]
2017-08-11 step added
    tests made
    variable A changed to match mNm
    [20170811_step_software_1.csv, 20170811_step_torque_software_20_20_100.csv]
2017-08-14 torque in mNm
    contactTorque adjusted to mNm
2017-08-14 tualposition_data change from uint32 to int32
    - also step and zero plots now
    - some println removed
2017-08-14 tests analysis
    [20170811_step_torque_software_20_5_200.csv]
2017-08-14 tests made without gravity effect
    [teste_1.csv, teste_10.csv, teste_11.csv, teste_12.csv, teste_13.csv, teste_2.csv, teste_3.csv, teste_4.csv]
2017-08-16 file organization
    - folder changed from matlab to csvData
    - files renamed
    [20170705-freeFall-i_20_b_20_k_100.csv, 20170705-freeFall_i_20_b_5_k_200.csv, 20170705-interruptedFall-i_20_b_20_k_100.csv, 20170705-interruptedFall-i_20_b_5_k_200.csv, 20170707-delayTests_1.csv, 20170707-delayTests_2.csv, 20170707-delayTests_3.csv, 20170712-loadcellTests_1.csv]
2017-08-25 parameters estimation matlab
    - comparing EPOS and Arduino position
    - delay between them is very small
    - estimating parameters with tfest
    - significant differences between matrix A and parameters set in arduino controller
2017-09-12 inertia value fixed
    inertia had to be inverted because 1/J
    [20170811-stepTorqueSoftware-i_005_b_20_k_100.csv, 20170811-stepTorqueSoftware-i_005_b_5_k_200.csv, 20170816-stepTorqueSoftware-i_002_b_1_k_10_T_50.csv, 20170816-stepTorqueSoftware-i_005_b_1_k_10_T_100.csv, 20170816-stepTorqueSoftware-i_005_b_1_k_10_T_100_2.csv, 20170816-stepTorqueSoftware-i_005_b_1_k_10_T_50.csv, 20170816-stepTorqueSoftware-i_005_b_1_k_10_T_50_2.csv, 20170816-stepTorqueSoftware-i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]
2017-09-12 analysis of arduino's reference model
2017-10-23 Update ModExo.h
    Position correction of Encoder Mode added.
    [ModExo.h]
2017-10-24 encoderControl enhanced
    - position no longer is limited to one turn
    - max position Limit increased
    [ModExo.h, arduino_control.ino]
2017-10-24 isse #6 solved
    - auxiliar int variable created
    [ModExo.h]
2017-10-25 wireCase CAD files
    [proteção celula de carga Rafa.igs, proteção celula de carga Rafa.ipt, proteção celula de carga Rafa.stp]
2017-10-27 interface for arduino
2017-10-27 new experiments made
    [20171027-stepTorqueSoftware-i_005_b_02_k_2_T_100.csv, 20171027-stepTorqueSoftware-i_005_b_02_k_2_T_50.csv, 20171027-stepTorqueSoftware-i_005_b_1_k_2_T_100.csv, 20171027-stepTorqueSoftware-i_005_b_1_k_2_T_50.csv, 20171027-stepTorqueSoftware-i_005_b_1_k_5_T_100.csv, 20171027-stepTorqueSoftware-i_005_b_1_k_5_T_50.csv]
2017-11-06 kiCAD schematics added
    [high_level_layer.sch, low_level_layer.sch, modexo.sch]
2017-11-28 Added Encoder Positioning in Differential Mode
2017-11-28 decoupled euler integration from sensor reading
    - control sample rate went from 50ms to 4ms
